jlpoltrack/HP3456A-7.5/hardware/u7-adapter/Render-Copper.png

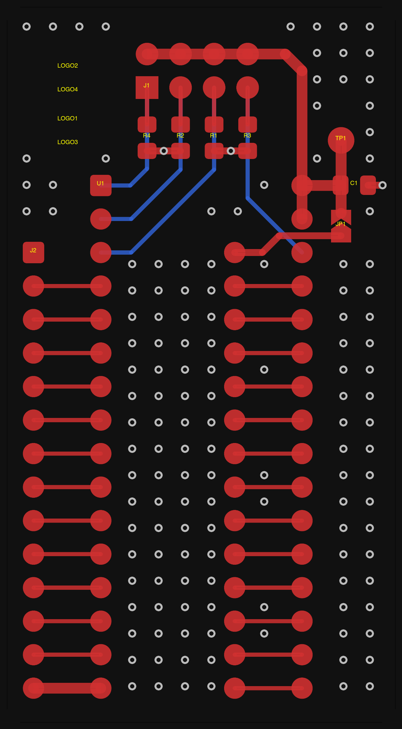
hardware/u7-adapter/Render-Copper.png
