jlpoltrack/HP3456A-7.5/hardware/u7-adapter/renders/Routing-Front.png

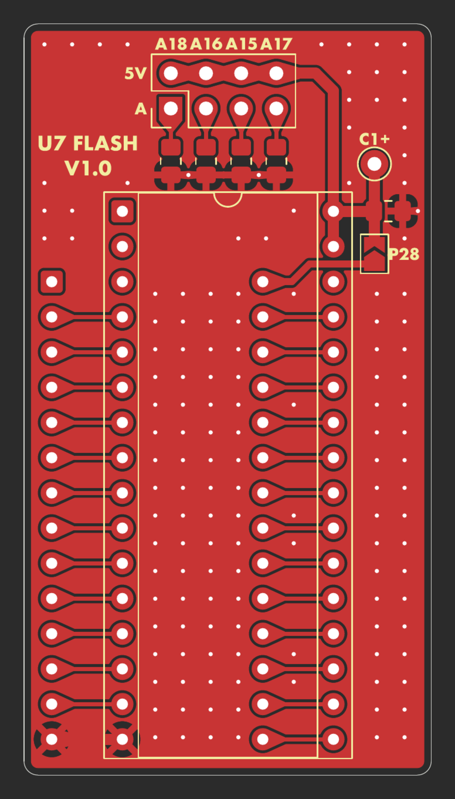
hardware/u7-adapter/renders/Routing-Front.png
