jlpoltrack/HP3456A-7.5/hardware/u7-adapter/production/bom.csv

Designator | Footprint | Quantity | Value | LCSC Part #
C1 | 0805 | 1 | 100n
J1 | PinHeader_2x04_P2.54mm_Vertical | 1 | BANK
J2 | DIP-28_W15.24mm_Plug | 1 | U7
R1, R2, R3, R4 | 0805 | 4 | 10k
U1 | DIP-32_W15.24mm_Socket | 1 | SST39SF040
