jlpoltrack/HP3456A-7.5/hardware/u7-adapter/U7-Flash-Adapter.pdf

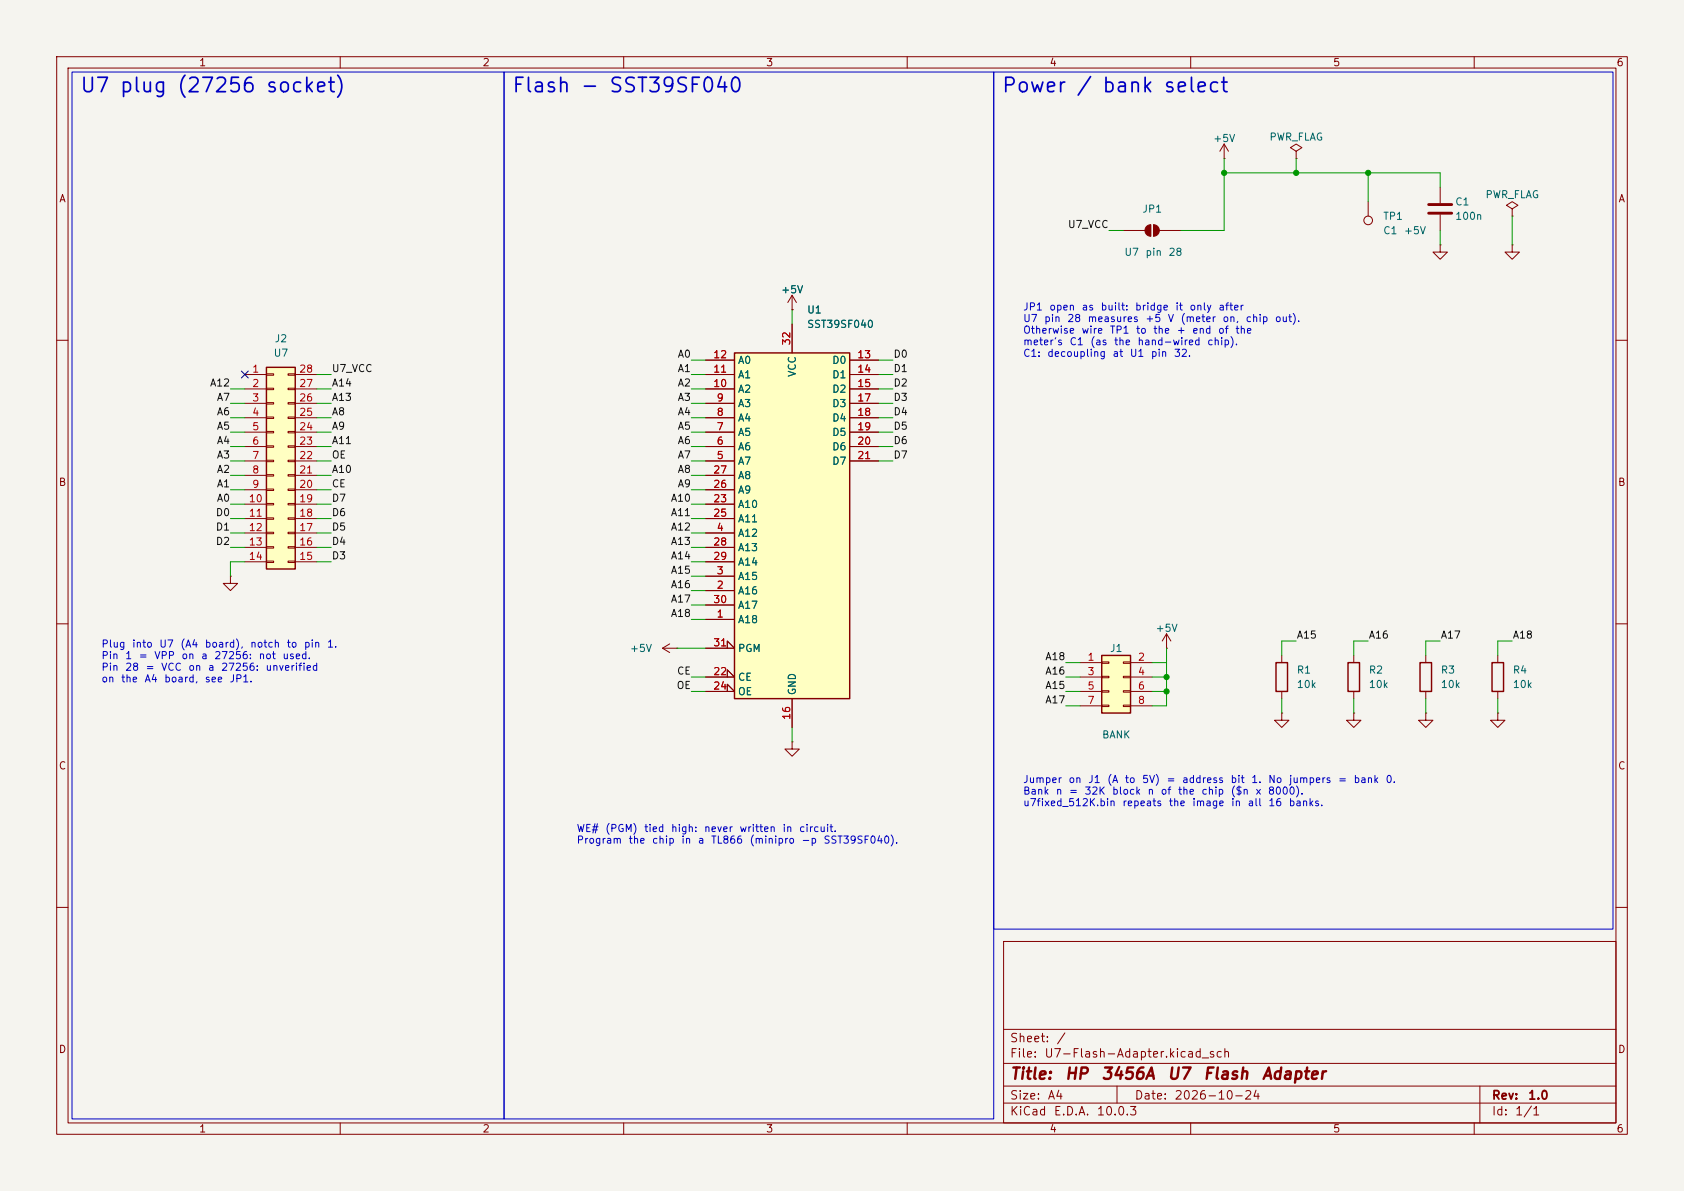
[picture p6: page 1]

A16 WE# (PGM) tied high: never written in circuit. Program the chip in a TL866 (minipro -p SST39SF040).

Plug into U7 (A4 board), notch to pin 1. Pin 1 = VPP on a 27256: not used. Pin 28 = VCC on a 27256: unverified

Sheet: /
File: U7-Flash-Adapter.kicad_sch
Title: HP 3456A U7 Flash Adapter

Size: A4 | Rev: 1.0
KiCad E.D.A. 10.0.3 | Id: 1/1
