jlpoltrack/HP3456A-7.5/hardware/u7-adapter/U7-Flash-Adapter.kicad_pcb

## KiCad design hardware/u7-adapter/U7-Flash-Adapter.kicad_pcb (2026-10-24)

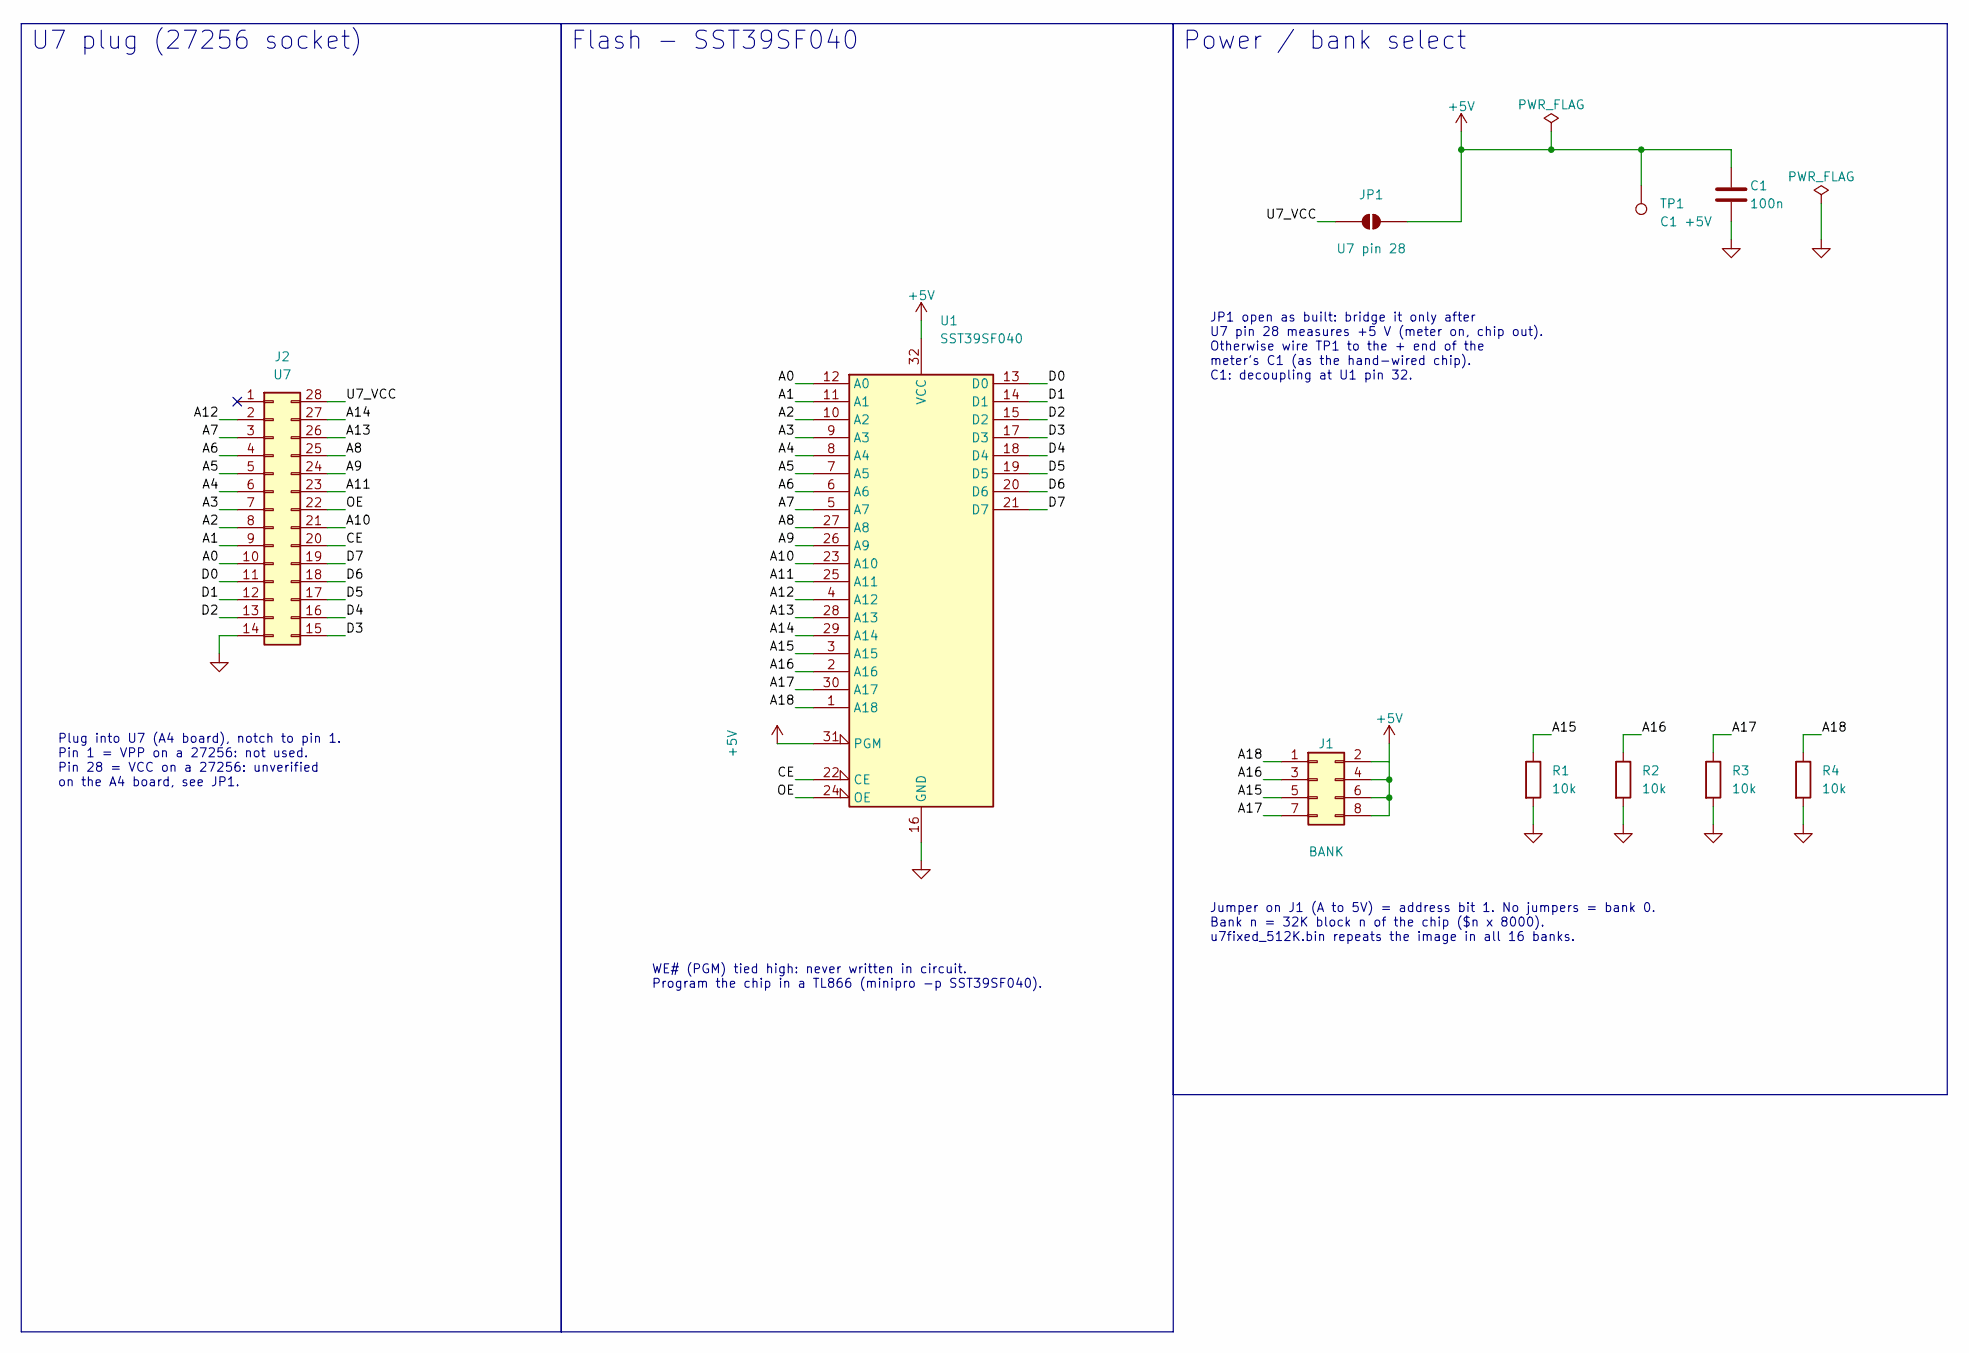
[picture p7: schematic U7-Flash-Adapter.kicad_sch, HP 3456A U7 Flash Adapter]

Parts:
C1: 100n; C_0805_2012Metric_Pad1.18x1.45mm_HandSolder
J1: BANK; PinHeader_2x04_P2.54mm_Vertical
J2: U7; DIP-28_W15.24mm_Plug
JP1: U7 pin 28; SolderJumper-2_P1.3mm_Open_TrianglePad1.0x1.5mm
R1, R2, R3, R4: 10k; R_0805_2012Metric_Pad1.20x1.40mm_HandSolder
TP1: C1 +5V; TestPoint_THTPad_D2.0mm_Drill1.0mm
U1: SST39SF040; DIP-32_W15.24mm_Socket

Connections:
+5V: C1.1, J1.2, J1.4, J1.6, J1.8, JP1.2 (B), TP1.1 (1_1), U1.31 (PGM), U1.32 (VCC)
/A0: J2.10, U1.12 (A0)
/A1: J2.9, U1.11 (A1)
/A2: J2.8, U1.10 (A2)
/A3: J2.7, U1.9 (A3)
/A4: J2.6, U1.8 (A4)
/A5: J2.5, U1.7 (A5)
/A6: J2.4, U1.6 (A6)
/A7: J2.3, U1.5 (A7)
/A8: J2.25, U1.27 (A8)
/A9: J2.24, U1.26 (A9)
/A10: J2.21, U1.23 (A10)
/A11: J2.23, U1.25 (A11)
/A12: J2.2, U1.4 (A12)
/A13: J2.26, U1.28 (A13)
/A14: J2.27, U1.29 (A14)
/A15: J1.5, R1.1, U1.3 (A15)
/A16: J1.3, R2.1, U1.2 (A16)
/A17: J1.7, R3.1, U1.30 (A17)
/A18: J1.1, R4.1, U1.1 (A18)
/CE: J2.20, U1.22 (CE)
/D0: J2.11, U1.13 (D0)
/D1: J2.12, U1.14 (D1)
/D2: J2.13, U1.15 (D2)
/D3: J2.15, U1.17 (D3)
/D4: J2.16, U1.18 (D4)
/D5: J2.17, U1.19 (D5)
/D6: J2.18, U1.20 (D6)
/D7: J2.19, U1.21 (D7)
/OE: J2.22, U1.24 (OE)
/U7_VCC: J2.28, JP1.1 (A)
GND: C1.2, J2.14, R1.2, R2.2, R3.2, R4.2, U1.16 (GND)

Notes on the sheet:
U7 plug (27256 socket)
Flash - SST39SF040
Power / bank select
Plug into U7 (A4 board), notch to pin 1. Pin 1 = VPP on a 27256: not used. Pin 28 = VCC on a 27256: unverified on the A4 board, see JP1.
WE# (PGM) tied high: never written in circuit. Program the chip in a TL866 (minipro -p SST39SF040).
JP1 open as built: bridge it only after U7 pin 28 measures +5 V (meter on, chip out). Otherwise wire TP1 to the + end of the meter's C1 (as the hand-wired chip). C1: decoupling at U1 pin 32.
Jumper on J1 (A to 5V) = address bit 1. No jumpers = bank 0. Bank n = 32K block n of the chip ($n x 8000). u7fixed_512K.bin repeats the image in all 16 banks.

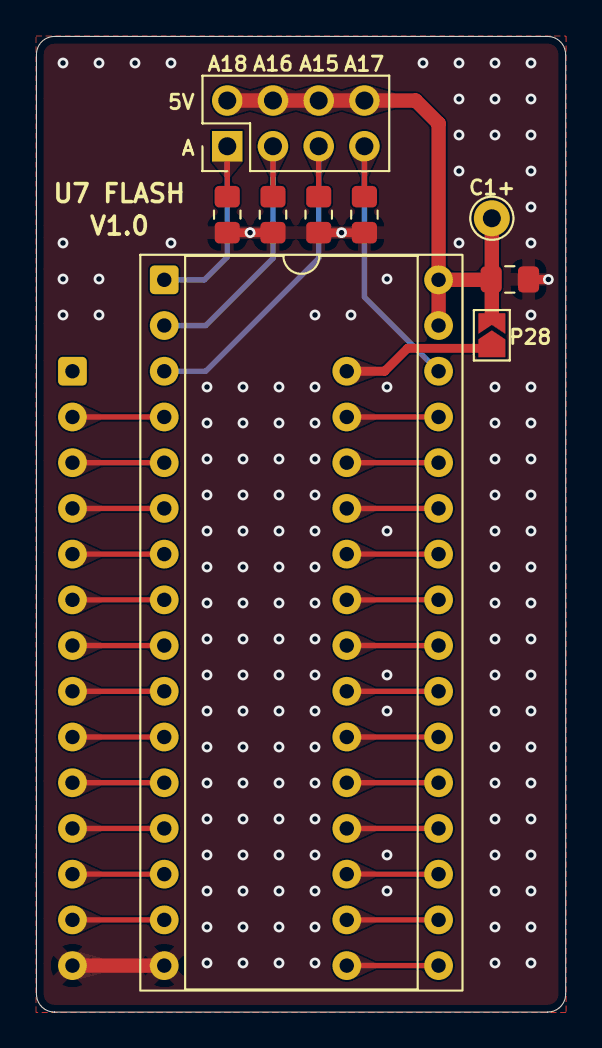
[picture p8: board U7-Flash-Adapter.kicad_pcb from above]

Board: 2 copper layers, 29.4 x 54.2 mm, 14 parts (0 on the bottom side), 32 nets.

Other parts of the board:
LOGO1, LOGO2, LOGO3, LOGO4: title
