jlpoltrack/HP3456A-7.5/src/u7fixed.asm

;
; Commented disassembly of 3456A U7 32K ROM
;
; Disassembled with the DASMx disassembler v 1.40 from http://myweb.tiscali.co.uk/pclare/DASMx/
;
; Some rearrangement of this code has been done to eliminate some jumps and branches
; to improve readability, but otherwise the code is unchanged.
;
; Naming Convention
;
; The disassembler created label names Lhhhh where hhhh is the hex location in the original
; code.  Because of all the deleted branches and jumps (hundreds, actually) in
; straightening up the code, the labels no longer assemble into the previously
; absolute locations, but that doesn't matter.
;
; The disassembler created variable (RAM storage locations) with names Xhhhh, where
; hhhh is again the hex locations.  Where variables have been found to be local to
; only one subroutine, the first letter was changed from "X" to "x" to make it easier
; to distinguish between local and global variables when reading the code.
;
; Where the purpose of a variable or subroutine has been determined with some confidence
; a descriptive name has been given.
;
; Subroutine names are sub*.  I/O addresses are io*.  Names not starting with
; sub or io are variables.
;
;
; ROM Space
;
; The ROM space on the 3456A is the top 32K of the memory map, although the installed
; ROMs only used the top 24K of that.  We're going to use a 32KB (or larger) ROM so
; we will just reserve the first 8K for nothing.

	code
	org	$8000	; 32KB for start of ROM
	rmb	$2000	; 8K of zeros -> code occupies top 24K of ROM space
;


;=====================================================================================

;===============================================================================
;
; Symbols - with notes on their usage
;
;===============================================================================
X0000	equ	$0000
X0001	equ	$0001
X0002	equ	$0002	; used with 0003 for index pointers
X0003	equ	$0003
x0004	equ	$0004	; local in subNMI
x0005	equ	$0005	; local in subNMI
x0008	equ	$0008	; local in subNMI
x0009	equ	$0009	; local in subNMI
x000C	equ	$000C	; local in subNMI
x000E	equ	$000E	; local in subNMI
x0014	equ	$0014	; local in subNMI
X0016	equ	$0016	; local in subNMI
X0024	equ	$0024	; local in subIRQ
X0025	equ	$0025	; local in subIRQ
X0026	equ	$0026	; local in subIRQ
X0027	equ	$0027	; local in subIRQ
X0028	equ	$0028	; local in subIRQ
X0029	equ	$0029	; local in subIRQ
X002A	equ	$002A	; local in subIRQ
X002C	equ	$002C	; local in subIRQ
X002E	equ	$002E	; local in subIRQ
X002F	equ	$002F	; local in subIRQ
X0032	equ	$0032	; local in subIRQ
Digit7	equ	$0040	; ***** MODDED stores the 7th digit *****
flag7Digits	equ	$0041	; ***** MODDED indicates 7 display digits selected  *****
x0044	equ	$0044	; local in many subs
x0045	equ	$0045	; used with above to form index in several subs
x0046	equ	$0046	; local in several subs
x0047	equ	$0047	; used with above to form index in subStoreDisplayToRegister
x0048	equ	$0048	; local in many subs
x0049	equ	$0049	; used with above to form index in many subs
x004A	equ	$004A	; local in many subs
x004B	equ	$004B	; used with above to form index in many subs
x004C	equ	$004C	; local in many subs
x004D	equ	$004D	; used with above to form index in several subs
x004E	equ	$004E	; local in many subs
x004F	equ	$004F	; used with above to form index in several subs
x0050	equ	$0050	; local in many subs
x0051	equ	$0051	; used with above to form index in 2 subs
x0052	equ	$0052	; local in subSetAnnuncByte4
x0054	equ	$0054	; local in several subs
x0056	equ	$0056	; local in subSetAnnuncByte4
x0058	equ	$0058	; local in sub107, sub116
x005A	equ	$005A	; local in subSetAnnuncByte4
x005E	equ	$005E	; local in subSetAnnuncByte4, sub023
x005F	equ	$005F	; used with above to form index in sub023
x0066	equ	$0066	; local in subSetAnnuncByte4
x00BC	equ	$00BC	; local in subWaitForIGStatus, for timeout length of Inguard response
StackStart	equ	$0101	; stack starts at 00FF
X0103	equ	$0103	; flag used in sub081, set in sub116, subIRQ
flagOutputEOI	equ	$0104	; =1 if EOI to be output with readings on HPIB
flagHPIBPackedOutput	equ	$0105	; flag used in sub019, sub023, subHPIBOutputMeasurement, sub078, set in sub
flagHPIBOutputStatus	equ	$0106	; = Talker Active (08) | Ready for Data (10) | Output Empty (40)
flagDispNeedUpdate	equ	$0107	; = 1 if display needs to be updated
X0108	equ	$0108	; counter variable? in sub043, subMathFcnStats
flagMeasFormatted	equ	$0109	; = 1 if current measurement is formatted for output (?)
X010A	equ	$010A	; flag used in subAnnuncNDisplayUpdate, set in sub089
flag010B	equ	$010B
X010C	equ	$010C	; flag used in sub078,sub086,sub103, set in sub060
flagHPIBByteInIntr	equ	$010D	; 1=HPIB will issue interrupts on data received.
x0117	equ	$0117	; local in subCheckIfIGReadyToMeasure,sub060,sub062
x0118	equ	$0118	; used with above as index
x0119	equ	$0119	; local in subGetInguardReading,sub060,sub077,subRST, passes value sub012 to sub011
X011A	equ	$011A	; passes value sub012 to sub011
X011B	equ	$011B	; may be global
x011C	equ	$011C	; local in many subs
InguardStatus	equ	$011D
X011E	equ	$011E	; local in several subs and returns value from sub062
x011F	equ	$011F	; local in sub063, sub088
PressedKeyCode	equ	$0120	; local in subIRQ
flagX0121	equ	$0121
flagHPIBOutput	equ	$0122	; bit4=service requested,bit6,bit7=multiple readings out
InguardCmd	equ	$0123
X0124	equ	$0124	; set in sub016 from table values, used in sub078
IGCmdRegister0	equ	$0125	; global, 69@reset, set from table values in sub098,subTestInguardMeasuring
IGCmdRegister1	equ	$0126
IGCmdRegister2	equ	$0127
IGCmdRegister3	equ	$0128	; set in sub112, used in subHPIBRequestService
IGCmdRegister4	equ	$0129	; bit0,1 are for # digits displayed
X012A	equ	$012A	; measurement digit? set in sub114, used in sub028,sub077,sub116,subNMI
X012B	equ	$012B
X012C	equ	$012C
X012D	equ	$012D
X012E	equ	$012E


; --- 7 byte Registers --- some are described in manual, Table 3.2
; offsets given from address $0125
; data structure:
;	byte0	polarity, FF = negative, 00 = positive
;	byte1	lower nibble holds "overrange" BCD digit (0 or 1), upper nibble is where decimal would be
;	byte2	digits 1,2
;	byte3	digits 3,4
;	byte4	digits 5,6
;	byte5	additional digits for calculation
;	byte6	exponent, 2's compliment if negative

; appears to be used in statistics calculations
X010E	equ	$010E
X010F	equ	$010F
X0110	equ	$0110
X0111	equ	$0111
X0112	equ	$0112
X0113	equ	$0113
X0114	equ	$0114

; R, offset = 0A
RegisterR0	equ	$012F
RegisterR1	equ	$0130
RegisterR2	equ	$0131
RegisterR3	equ	$0132
RegisterR4	equ	$0133
RegisterR5	equ	$0134
RegisterR6	equ	$0135

; Y, offset = 11
RegisterY0	equ	$0136
RegisterY1	equ	$0137
RegisterY2	equ	$0138
RegisterY3	equ	$0139
RegisterY4	equ	$013A
RegisterY5	equ	$013B
RegisterY6	equ	$013C

; Z, offset = 18
RegisterZ0	equ	$013D
RegisterZ1	equ	$013E
RegisterZ2	equ	$013F
RegisterZ3	equ	$0140
RegisterZ4	equ	$0141
RegisterZ5	equ	$0142
RegisterZ6	equ	$0143

; LOWER, offset = 1F
RegisterL0	equ	$0144	; 0144-014A set in subPresetLnUregs to FF 01 99 99 99 00 10 (= -1.999999E9)
RegisterL1	equ	$0145
RegisterL2	equ	$0146
RegisterL3	equ	$0147
RegisterL4	equ	$0148
RegisterL5	equ	$0149
RegisterL6	equ	$014A

; UPPER, offset = 26
RegisterU0	equ	$014B	; 014B-0151 set in subPresetLnUregs to 00 01 99 99 99 00 10 (= +1.999999E9)
RegisterU1	equ	$014C
RegisterU2	equ	$014D
RegisterU3	equ	$014E
RegisterU4	equ	$014F
RegisterU5	equ	$0150
RegisterU6	equ	$0151

; Count, offset = 2D
RegisterC0	equ	$0152
RegisterC1	equ	$0153
RegisterC2	equ	$0154
RegisterC3	equ	$0155
RegisterC4	equ	$0156
RegisterC5	equ	$0157
RegisterC6	equ	$0158

; STAT1, offset = 34, used in statistics calculations, sum of (xi - x1)^2
RegisterSTAT10	equ	$0159
RegisterSTAT11	equ	$015A
RegisterSTAT12	equ	$015B
RegisterSTAT13	equ	$015C
RegisterSTAT14	equ	$015D
RegisterSTAT15	equ	$015E
RegisterSTAT16	equ	$015F

; STAT2, offset = 3B, sum of (xi - x1)
RegisterSTAT20	equ	$0160
RegisterSTAT21	equ	$0161
RegisterSTAT22	equ	$0162
RegisterSTAT23	equ	$0163
RegisterSTAT24	equ	$0164
RegisterSTAT25	equ	$0165
RegisterSTAT26	equ	$0166

; AccumRegister, offset	= 42
AccumRegister0	equ	$0167
AccumRegister1	equ	$0168
AccumRegister2	equ	$0169
AccumRegister3	equ	$016A
AccumRegister4	equ	$016B
AccumRegister5	equ	$016C
AccumRegister6	equ	$016D

; STAT3, offset = 4A, (xi - x1)
RegisterSTAT30	equ	$016F
RegisterSTAT31	equ	$0170
RegisterSTAT32	equ	$0171
RegisterSTAT33	equ	$0172
RegisterSTAT34	equ	$0173
RegisterSTAT35	equ	$0174
RegisterSTAT36	equ	$0175

; also some registers are used but maybe just as temporary scratch variables
X0176	equ	$0176	; register 0176-017C start byte
X017D	equ	$017D	; register 017D-0183 start byte
; register at 0184-018A is used to hold x1 for statistics calculations, but individual bytes are not addre
; --- end of 7 byte registers ---

X018B	equ	$018B
X018C	equ	$018C
CopyOfIGCmdByte	equ	$018D
X018E	equ	$018E
X018F	equ	$018F
BCDRoundupValue	equ	$0190	; either 01 or 05
X0191	equ	$0191	; local in sub085,sub086
X0192	equ	$0192	; local in sub085,sub086
InguardByte3	equ	$0193
InguardByte2	equ	$0194
InguardByte1	equ	$0195
InguardByte0	equ	$0196
AnDUpdatedFlag	equ	$0197	; = 1 once Annunciator and Display updated
X0198	equ	$0198
X0199	equ	$0199	; set in sub027, used in sub012
X019A	equ	$019A	; set in sub027, used in sub012
X019B	equ	$019B
X019C	equ	$019C
X019D	equ	$019D	; flag, 0,1
DecimalPosition	equ	$019E	; set in sub027, used in sub026
x019F	equ	$019F	; local in sub112
X01A0	equ	$01A0	; local in subRunMeasurement
flag01A1	equ	$01A1	; flag, set to 1 or 2 in sub116, cleared in other subs
flagCmdParse	equ	$01A2	; bits0,3,4,6,7 used as flags
CmdChar	equ	$01A3	; ASCII character from command
X01A4	equ	$01A4	; local in sub023
X01A5	equ	$01A5	; local in sub023
X01A6	equ	$01A6	; temp store for MeasExponent
X01A7	equ	$01A7	; temp store for MeasExponentSign
X01A8	equ	$01A8	; local in sub085
X01A9	equ	$01A9	; set in sub028, used in sub085,sub087
MeasArrayORd	equ	$01AA	; MeasArray 1-4 or'd together
X01AB	equ	$01AB	; set in subRunSelfTest,114, used in sub096,sub098,subTestInguardMeasuring
X01AC	equ	$01AC	; local in subRunSelfTest
flagTestMode	equ	$01AD	; bit0 = 1 puts unit in test mode, bit1 action unknown.
flagInguardTimeout	equ	$01AE	; set to FF if timeout waiting for data from Inguard
flagInguard1stTimeout	equ	$01AF	; 0 and set to 1 after 1st timeout from inguard
x01B0	equ	$01B0	; local
X01B1	equ	$01B1
X01B2	equ	$01B2

; 01B8-C5 are formatted measurment, 14 bytes of ASCII
FormattedReading0	equ	$01B8
FormattedReading1	equ	$01B9
FormattedReading2	equ	$01BA
FormattedReading3	equ	$01BB
FormattedReading4	equ	$01BC
FormattedReading5	equ	$01BD
FormattedReading6	equ	$01BE
FormattedReading7	equ	$01BF
FormattedReading8	equ	$01C0
FormattedReading9	equ	$01C1
FormattedReading10	equ	$01C2
FormattedReading11	equ	$01C3
FormattedReading12	equ	$01C4
FormattedReading13	equ	$01C5
X01C6	equ	$01C6
X01C7	equ	$01C7
DecimalDisplayPosition	equ	$01C8	; 6 = leading digit, 5 = next digit, then 4 then 3
X01C9	equ	$01C9
x01CA	equ	$01CA	; local used in several routines

X01CC	equ	$01CC
X01CD	equ	$01CD
X01CE	equ	$01CE
X01CF	equ	$01CF
CmdTableIndex	equ	$01D0	; used to pass value into subCmdTableLookup and as a local in several routines
MeasArray0	equ	$01D1	; least significant digit
MeasArray1	equ	$01D2	; contains reading from Inguard.
MeasArray2	equ	$01D3	; initially packed in 1st 4 bytes as 2 digit BCD
MeasArray3	equ	$01D4	; later 1 BCD digit per byte
MeasArray4	equ	$01D5
MeasArray5	equ	$01D6
MeasArray6	equ	$01D7
MeasArray7	equ	$01D8	; most significant digit
DisplayArray0	equ	$01D9	; these values are sent to the display.  One will be ASCII "."
DisplayArray1	equ	$01DA
DisplayArray2	equ	$01DB
DisplayArray3	equ	$01DC
DisplayArray4	equ	$01DD
DisplayArray5	equ	$01DE
DisplayArray6	equ	$01DF
DisplayArray7	equ	$01E0
flagDisplayHasExponent	equ	$01E1	; = 1 if exponent not zero
DisplayExponentSign	equ	$01E2
DisplayExponent	equ	$01E3
DisplayPolaritySign	equ	$01E4
flagDisplayArrayHasNoDecimal	equ	$01E5	; = 1 when 1 BCD digit/byte
X01E7	equ	$01E7
flag01ED	equ	$01ED	; only set = 1 in sub107,sub112
MeasPolaritySign	equ	$01EE	; contains "+" or "-" ASCII
flagMeasArrayUnpacked	equ	$01EF	; = 1 when 1 BCD digit/byte
tempCmdParseFlag	equ	$01F0
X01F1	equ	$01F1
MeasExponentSign	equ	$01F2	; contains "+" or "-" ASCII
flagMeasHasExponent	equ	$01F3	; = 1 if exponent not zero
MeasExponent	equ	$01F4	; one digit exponent
AnnuncByte0	equ	$01F5	; data that controls front panel LEDs
AnnuncByte1	equ	$01F6
AnnuncByte2	equ	$01F7
AnnuncByte3	equ	$01F8
AnnuncByte4	equ	$01F9
AnnuncByte6	equ	$01FA	; controls leading +/-1 digit (5th byte is exponent polarity, is not stored separate
flagX01FB	equ	$01FB	; only bits6,1,0 used, set and tested in subIRQ, cleared elsewhere
				; bit6 = 1 means entering exponent
flagX01FC	equ	$01FC
HPIBIntrMask	equ	$01FD
X01FE	equ	$01FE	; pointer to something in user RAM
X01FF	equ	$01FF
X0200	equ	$0200	; some indicator of user RAM
X0201	equ	$0201	; pointer to something in user RAM
X0202	equ	$0202	; with above
X0203	equ	$0203	; pointer to next user RAM data storage location
X0204	equ	$0204	; with above
X0205	equ	$0205	; pointer to something in user RAM
X0206	equ	$0206

; 0207 to 05EE appear to be the user storage space (see sub085)
X0789	equ	$0789	; flag
X078A	equ	$078A	; set in sub027, used for comparisons in sub016
flagNumPLCcode	equ	$078B	; # power line cycles to integrate = 0,1,2,3,4 for .01,.1,1,10,100
X078C	equ	$078C	; passes value into sub010, sub012, subInsertDisplayDecimal, set in sub016, sub027
flagOverrange_Maybe	equ	$078D	; flag, values 0,1
ErrorNumber	equ	$078E	; takes values 1-3,5,6, stored in MeasArray1 in subDisplayError
HPIBSerialPollStatus	equ	$078F	; mask used in subHPIBRequestService, takes values 01,02,04,08,10,12,20,80
X0790	equ	$0790	; offset for arrays from 0125, values 0A,11,18,1F,26,2D or 42
X0791	equ	$0791	; word of flag bits
HPIBSerialPollMask	equ	$0792	; mask for HPIB serial poll, values FB,FE
X0793	equ	$0793	; passes register offset into subCopyAccumRegToRegister, values 1E,25,2C,49,57,65
IdxPtr0169	equ	$0794	; used to hold index pointer set to 0RegisterSTAT21
IdxPtr0174	equ	$0796
X0798	equ	$0798	; local in subRunMeasurement
X0799	equ	$0799	; local in sub104
X079A	equ	$079A	; local in sub104
X079B	equ	$079B	; with 079C used with index reg., values F8B1,F857,F861
X079C	equ	$079C
X079D	equ	$079D	; holds offset for register, values given in sub114 0A,11,18,1F,26 or 42
x079E	equ	$079E	; local in subStoreDisplayToRegister for holding version of DisplayExponent
X079F	equ	$079F	; holds index, values F84D,F857,F861,F86B,F875,F87F,F889,F893,F89D,F8A7,F8CB,F8CC,F8F7
IGCmdRegisterNumber	equ	$07A1	; values set in sub114 of 00,01,02,04.  Used in subAdjustIGCmdRegister to cr
IGCmdRegBitClearMask	equ	$07A2	; mask used in subAdjustIGCmdRegister, values set in sub114,116,IRQ

; The following variables are used inside the math subroutines subMath*
X07A5	equ	$07A5	; X07A5-x07C6 are local variables used for math functions
X07A6	equ	$07A6	; in subRegisterAdd-141
X07A7	equ	$07A7	; X07A5-B hold result of register math functions
X07A8	equ	$07A8
X07A9	equ	$07A9
X07AA	equ	$07AA
X07AB	equ	$07AB
X07B0	equ	$07B0
X07B1	equ	$07B1	; X07B1-7 hold 2nd argument passed to register math functions
X07B2	equ	$07B2
X07B3	equ	$07B3
X07B4	equ	$07B4
X07B5	equ	$07B5
X07B6	equ	$07B6
X07B7	equ	$07B7
X07B8	equ	$07B8	; X07B8-E hold 1st argument passed to register math functions
X07B9	equ	$07B9
X07BA	equ	$07BA
X07BB	equ	$07BB
X07BC	equ	$07BC
X07BD	equ	$07BD
X07BE	equ	$07BE
x07BF	equ	$07BF	; set in subMath04,126, not used.
x07C0	equ	$07C0	; local in subMath10-134
x07C1	equ	$07C1	; local in subMath17-141
x07C2	equ	$07C2	; local in subMath10-134
x07C3	equ	$07C3	; local in subMath17-141
x07C4	equ	$07C4	; local in subMath10-134 (index with 07C5)
x07C6	equ	$07C6	; local in subMath10-141 (index with 07C5)
x07C8	equ	$07C8	; local in subMath24-156 (index with 07C9)
x07CA	equ	$07CA	; local in subMath22-157 (index with 07CB)
x07CC	equ	$07CC	; local in subMath22-157 (index with 07CD)
x07CE	equ	$07CE	; local in subMath28

; Memory mapped I/O addresses

ioIsoLogic	equ	$0800
ioVmComplete	equ	$1000
ioRateLite	equ	$1800
ioDAdata	equ	$3000
ioIOreset	equ	$3800
ioHPIB_r0	equ	$4000
ioHPIB_r1	equ	$4001
ioHPIB_r2	equ	$4002
ioHPIB_r3	equ	$4003
ioHPIB_r4	equ	$4004
ioHPIB_r5	equ	$4005
ioHPIB_r6	equ	$4006
ioHPIB_r7	equ	$4007
ioKBrdStrb	equ	$4800
ioKBrdClr	equ	$5000
ioDsplyStrb	equ	$5800
ioAnnunc	equ	$6000
ioSAstrb1	equ	$6800
ioSAstrb2	equ	$7000

;===============================================================================
; Routines for Signature Analysis service procedures
SigAnalyzer1:
	sei
	lds	#$00FF
	stab	ioKBrdClr
	cli
LA008:
	staa	ioSAstrb1
	ldaa	#$55
LA00D:
	ldx	#$0000
LA010:
	staa	$00,x
	cmpa	$00,x
	bne	LA028
	coma
	inx
	staa	$00,x
	cmpa	$00,x
	bne	LA028
	coma
	inx
	cpx	#$0800
	bne	LA010
	coma
	bmi	LA00D
LA028:
	nop
	clra
	sec
	staa	ioSAstrb2
LA02E:
	rora
	staa	ioDAdata
	staa	ioDsplyStrb
	staa	ioAnnunc
	staa	ioVmComplete
	staa	ioRateLite
	staa	ioIOreset
	staa	ioHPIB_r0
	bhi	LA02E
	bra	LA008
;
SigAnalyzer2:
	ldaa	ioKBrdStrb
	anda	#$BF
	staa	ioKBrdClr
	lds	#$00FF
	psha
	cli
	ldab	#$FF
	stab	ioIsoLogic
LA05A:
	staa	ioSAstrb1
	pula
	des
	ldab	#$07
LA061:
	staa	ioDAdata
	asra
	decb
	cmpb	#$00
	bhi	LA061
	ldab	#$8F
	stab	ioIsoLogic
	stab	ioKBrdStrb
	stab	ioKBrdClr
	staa	ioSAstrb2
	bra	LA05A
;
	db	$FF, $FF, $FF, $FF
	db	$FF, $FF, $FF
;
;===============================================================================
; MeasArray7 is the left-most, most signifcant digit
subShiftMeasArrayLeft:
	ldaa	MeasArray6
	staa	MeasArray7
	ldaa	MeasArray5
	staa	MeasArray6
	ldaa	MeasArray4
	staa	MeasArray5
	ldaa	MeasArray3
	staa	MeasArray4
	ldaa	MeasArray2
	staa	MeasArray3
	ldaa	MeasArray1
	staa	MeasArray2
	ldaa	MeasArray0
	staa	MeasArray1
	clr	MeasArray0
	rts
;===============================================================================
; MeasArray7 is the left-most, most signifcant digit
subShiftMeasArrayRight:
	ldaa	MeasArray1
	staa	MeasArray0
	ldaa	MeasArray2
	staa	MeasArray1
	ldaa	MeasArray3
	staa	MeasArray2
	ldaa	MeasArray4
	staa	MeasArray3
	ldaa	MeasArray5
	staa	MeasArray4
	ldaa	MeasArray6
	staa	MeasArray5
	ldaa	MeasArray7
	staa	MeasArray6
	clr	MeasArray7
	rts
;===============================================================================
; packs measurement digits into FormattedReading2-D for HPIB "packed" data output
;
subPackReading:
	ldaa	#$2B		; ASCII "+"
	cmpa	MeasPolaritySign
	bne	LA0EF
	clr	X01CC		; if MeasPolaritySign = "+"
	bra	LA0F4
;
LA0EF:				; sign is not "+"
	ldaa	#$02
	staa	X01CC		; bit2 is polarity, 1 = negative
LA0F4:
	ldaa	MeasArray7	; called "overrange" digit in manual
	cmpa	#$01
	beq	LA130		; branch if 1st digit = 1
	bsr	subShiftMeasArrayRight	; otherwise shift digits down one position
	ldaa	#$2B		; ASCII "+"
	cmpa	MeasExponentSign
	bne	LA110		; branch if negative exponent
	ldab	MeasExponent	; if MeasExponentSign = "+"
	incb
	stab	X01CE		; = exponent+1
	clr	X01CD
	bra	LA147
;
LA110:				; negative exponent
	ldaa	MeasExponent
	tsta
	bne	LA122
	ldab	#$01		; if MeasExponent = 0, 01CE = 01, 01CD = 80
	stab	X01CE
	ldaa	#$80
	staa	X01CD
	bra	LA147
;
LA122:
	ldaa	MeasExponent	; != 0
	deca
	staa	X01CE		; exponent -1
	ldaa	#$80
	staa	X01CD		; if MeasExponent != 0, 01CE = MeasExponent-1, 01CD = 80
	bra	LA147
;
LA130:				; first digit is 1
	ldaa	MeasExponent
	staa	X01CE
	ldaa	#$2B		; ASCII "+"
	cmpa	MeasExponentSign
	bne	LA142
	clr	X01CD		; if MeasExponentSign = "+", 01CE = MeasExponent, 01CD = 00
	bra	LA147
;
LA142:
	ldaa	#$80
	staa	X01CD	; if MeasExponentSign != "+", 01CE = MeasExponent, 01CD = 80

LA147:
	ldaa	X01CE
	asla
	asla
	oraa	X01CC	; = 00 if MeasPolaritySign = "+", else 02
	oraa	X01CD	; = 00 or 80
	oraa	MeasArray7
	staa	FormattedReading2

	; above constructs the 1st packed byte:
	;	bit7: 	exponent sign, 1 = -
	; 	bit6-2: exponent digit
	;	bit1: 	polarity sign, 1 = -
	;	bit0: 	overrange if 1

	ldaa	MeasArray6	; packs 6 digits into three bytes
	asla
	asla
	asla
	asla
	oraa	MeasArray5
	staa	FormattedReading3
	ldaa	MeasArray4
	asla
	asla
	asla
	asla
	oraa	MeasArray3
	staa	FormattedReading4
	ldaa	MeasArray2
	asla
	asla
	asla
	asla
	oraa	MeasArray1
	staa	FormattedReading5
	ldaa	MeasArray7
	tsta
	bne	LA18D
	jsr	subShiftMeasArrayLeft	; if MeasArray7 = 0, shift values in array up one position.
LA18D:
	rts

;===============================================================================
; Formats reading into character FormattedReading including signs, exponent and decimal.
; copies bytes from 01D1-01D8 (MeasArray) converting to ASCII.
; One byte contains ASCII ".", and it is copied too.
;
subFormatReadingForHPIB:
	ldaa	MeasPolaritySign
	staa	FormattedReading0	; 1st byte of formatted reading, the polarity
	ldaa	#$01
	staa	x01B0
LA19B:	;--- begin loop for each digit
	ldaa	x01B0	; loop counter index, 1-8
	cmpa	#$08
	bhi	LA1CC
	ldaa	#$B8
	ldab	#$01
	adda	x01B0
	adcb	#$00
	staa	x0049
	stab	x0048	; 01B9 to 01C1, FormattedReading1-9
	ldaa	#$08
	suba	x01B0	; A = 7...0
	clrb
	adda	#$D1
	adcb	#$01	; base address of MeasArray
	staa	x004D
	stab	x004C	; 01D8 to 01D1 (MeasArray)
	ldx	x004C
	ldaa	$00,x
	oraa	#$30	; turn on bits b4-5, converts BCD to ASCII digits
	ldx	x0048
	staa	$00,x
	inc	x01B0
	bra	LA19B
	;--- end loop
;
	; Array MeasArray has BCD digits and an ASCII ".".  Previous loop
	; copied values adding 30 to each to convert numbers to characters, and
	; added 30 to the decimal point.  This loop goes through all the digits
	; again and puts "." into the formatted array.
LA1CC:	;--- begin loop
	clr	x01CA
LA1CF:
	ldaa	x01CA	; loop counter index, 0-7
	cmpa	#$07
	bhi	LA209
	ldaa	#$D1
	ldab	#$01	; base address of MeasArray
	adda	x01CA
	adcb	#$00
	staa	x0049
	stab	x0048
	ldx	x0048	; 01D1 to 01D8 (MeasArray)
	ldaa	$00,x
	cmpa	#$2E	; ASCII "."
	bne	LA204
	ldab	#$08	; if current byte is decimal point
	subb	x01CA	; B = 8...1
	clra
	addb	#$B8
	adca	#$01
	stab	x004F
	staa	x004E
	ldaa	#$2E	; ASCII "."
	ldx	x004E	; place decimal in 01B9 to 01C1 array
	staa	$00,x
LA204:
	inc	x01CA
	bra	LA1CF
	;--- end loop
;
LA209:
	ldaa	MeasExponentSign
	staa	FormattedReading10
	ldaa	#$30
	oraa	MeasExponent
	staa	FormattedReading11
	rts
;===============================================================================
; sends a write pulse to clock a byte into display controller chip.
; (maybe two are necessary for timing?).
subStrobeDisplay:
	ldaa	#$01
	staa	ioDsplyStrb
	ldaa	#$01
	staa	ioDsplyStrb
	rts
;---------------------------------
; sends a write pulse to clock a byte into display controller chip.
subStrobeAnnunciator:
	ldaa	#$01
	staa	ioAnnunc
	ldaa	#$01
	staa	ioAnnunc
	rts
;===============================================================================
; sends all the data to update the Annunciator LEDs.  Controller chip blanks
; all output until an 8th byte is written.  Any extra writes are ignored.
; Annunciator also controls the exponent sign.
;
subWriteAnnunc:
	ldaa	#$B0		; data is coming command to chip
	staa	ioDAdata
	bsr	subStrobeAnnunciator
	ldaa	AnnuncByte0
	staa	ioDAdata
	bsr	subStrobeAnnunciator
	ldaa	AnnuncByte1
	staa	ioDAdata
	bsr	subStrobeAnnunciator
	ldaa	AnnuncByte2
	staa	ioDAdata
	bsr	subStrobeAnnunciator
	ldaa	AnnuncByte3
	staa	ioDAdata
	bsr	subStrobeAnnunciator
	ldaa	AnnuncByte4
	staa	ioDAdata
	bsr	subStrobeAnnunciator

	; ***** MODDED don't show exponent sign if 7 digit mode *****
	jsr	sub7thDigitShown	; FIX: was ldaa flag7Digits
	bne	LA270		; branch around code that sets exponent sign
	; end mod

	ldaa	flagDisplayHasExponent
	coma
	rora
	bcc	LA271		; branch if there is an exponent sign to display
LA270:				; new label
	ldaa	#$10		; code for display nothing
	staa	ioDAdata
	bra	LA292
;
LA271:				; these will be the exponent signs
	ldaa	#$2B		; ASCII "+"
	cmpa	DisplayExponentSign
	bne	LA27F
	ldab	#$17		; code for display "+"
	stab	ioDAdata
	bra	LA292
;
LA27F:
	ldaa	#$2D		; ASCII "-"
	cmpa	DisplayExponentSign
	bne	LA28D
	ldab	#$14		; code for display "-"
	stab	ioDAdata
	bra	LA292
;
LA28D:
	ldaa	#$10
	staa	ioDAdata
LA292:
	bsr	subStrobeAnnunciator
	ldaa	AnnuncByte6
	staa	ioDAdata
	bsr	subStrobeAnnunciator
	bsr	subStrobeAnnunciator
	rts
;===============================================================================
; fills AnnuncByte0-3, which set the state of all the front panel LEDs except
; for MATH, LISTEN, SRQ, TALK, REMOTE and FILTER (which are done in subSetAnnuncByte4).
;
LA31B:			; rearranged some branches for readability
	rts

subSetAnnuncBytes123:
	ldaa	flagTestMode
	tsta
	bne	LA31B		; if flagTestMode != 0, rts
	ldab	IGCmdRegister0
	lsrb
	lsrb
	lsrb
	lsrb
	lsrb		; IGCmdRegister0 bit5-7 now in bit0-2, max value is 7
	clra
	addb	#$9B	; offset = 0xF79B, possible range F79B to F7A2 -> data
	adca	#$F7		; range in ROM
	stab	x004D
	staa	x004C
	ldaa	IGCmdRegister1
	lsra
	ldab	IGCmdRegister0
	aslb
	aslb
	anda	#$08
	ldx	x004C
	oraa	$00,x	; values are $10, $14, $12, $11, $50, $30, $00, $18
	andb	#$40
	staa	x0054
	orab	x0054
	stab	AnnuncByte0	; data for 7 front panel LEDs
	ldaa	IGCmdRegister1
	lsra
	lsra
	lsra
	lsra
	lsra
	lsra		; IGCmdRegister1 bit6-7 now in bit0-1, max value is 3
	clrb
	adda	#$A2
	adcb	#$F7
	staa	x004B
	stab	x004A	; F7A2 to F7A5
	ldaa	IGCmdRegister4
	lsra
	lsra
	ldab	IGCmdRegister0
	andb	#$01
	ldx	x004A
	orab	$00,x	; values are $18, $00, $30, $50
	anda	#$02
	stab	x0050
	oraa	x0050
	staa	AnnuncByte1	; data for 7 front panel LEDs
	ldaa	#$0F
	anda	IGCmdRegister2
	staa	InguardStatus
	clrb
	adda	#$87
	adcb	#$F7
	staa	x004B
	stab	x004A
	ldaa	flagX0121
	asla
	asla
	anda	#$20
	ldx	x004A
	oraa	$00,x
	staa	AnnuncByte2
	ldaa	#$91
	ldab	#$F7
	adda	InguardStatus
	adcb	#$00
	staa	x0049
	stab	x0048
	ldaa	flagX0121
	anda	#$01
	asla
	asla
	ldx	x0048
	oraa	$00,x
	ldab	#$07
	andb	IGCmdRegister1
	staa	x004E
	clra
	cmpb	#$03
	bne	LA34C
	deca
LA34C:
	anda	#$10
	oraa	x004E
	staa	AnnuncByte3
	rts

;===============================================================================
; Updates the Display digits and Annunciator LEDs. Also determines signs and
; decimal points to display.
; inputs: X010A
;
; Coding for leading digit, AnnuncByte6:
;	- bits 0,1,2 = 010b (02) --> minus sign
;	- bits 0,1,2 = 111b (07) --> plus sign
;	- bits 4,3 = 01b (08) --> digit "1" on
;	- bits 4,3 = 10b (10) --> digit "1" off
;	- bit 5 on (20) --> decimal point displayed

subAnnuncNDisplayUpdate:

	ldaa	#$40
	anda	IGCmdRegister1
	tsta
	bne	LA361		; branch if bit6 = 1
	clr	ioIOreset
LA361:
	ldaa	flagDispNeedUpdate
	rora
	bcc	LA3CD		; if flagDispNeedUpdate = 0, return
	sei			; disable IRQ interrupts
	ldaa	#$10
	staa	ioHPIB_r0	; turn off interrupts from HPIB
	ldaa	X010A		; only set to 01 before first routine call from sub089
	cmpa	#$01
	bne	LA37A		; branch if != 1
	ldab	ioRateLite	; reading this port must strobe the enable line, toggling the LED?
	stab	X01CC		; why store this?  01CC is overwritten below.
LA37A:
	clr	X010A
	ldaa	#$2E		; ASCII "."
	cmpa	DisplayArray6
	bne	LA38B
	ldab	#$01
	stab	x01CA
	bra	LA38E
;
LA3CD:
	rts
LA38B:
	clr	x01CA		; x01CA = 0 if first full digit != ".", else 1
LA38E:
	ldaa	flagDisplayArrayHasNoDecimal
	tsta
	bne	LA39B
	ldab	#$06		; if flagDisplayArrayHasNoDecimal = 0
	stab	X01CC
	bra	LA3A0
LA39B:
	ldaa	#$07
	staa	X01CC
LA3A0:
	ldaa	#$D9
	ldab	#$01		; 01D9 is base of DisplayArray0
	adda	X01CC		; = 6 or 7
	adcb	#$00
	staa	x0049
	stab	x0048
	ldx	x0048
	ldaa	$00,x		; most signifcant digit, DisplayArray6 or DisplayArray7
	cmpa	#$01
	beq	LA412		; branch if a leading "1"
	; a leading "1" not to be displayed
	ldab	#$2B		; ASCII "+"
	cmpb	DisplayPolaritySign
	bne	LA3DD		; branch if not "+"
	ldaa	x01CA		; 0 or 1
	adda	#$02
	clrb
	adda	#$5C		; 5E or 5F
	adcb	#$F9
	staa	x0051
	stab	x0050
	ldx	x0050		; F95E or F95F
	ldaa	$00,x		; 17 or 37 -> "+" or "+."
	staa	AnnuncByte6	; +/-/1 digit on display
	jmp	LA462

LA3DD:
	ldaa	#$2D		; ASCII "-"
	cmpa	DisplayPolaritySign
	bne	LA3FB
	ldab	x01CA		; 0 or 1
	addb	#$0A		; 0A or 0B
	clra
	addb	#$5C		; 66 or 67
	adca	#$F9
	stab	x004D
	staa	x004C
	ldx	x004C
	ldaa	$00,x		; F966 = 12, F967 = 32 -> "-" or "-."
	staa	AnnuncByte6
	bra	LA462
;
LA3FB:				; arrive here if no polarity sign
	ldaa	x01CA		; 0 or 1
	adda	#$06		; 6 or 7
	clrb
	adda	#$5C
	adcb	#$F9
	staa	x004B
	stab	x004A
	ldx	x004A
	ldaa	$00,x		; F962 = 10, F963 = 30 -> " " or "." ?
	staa	AnnuncByte6
	bra	LA462
;
LA412:	; arrive here if a "1" to be displayed.
	ldaa	#$2B		; ASCII "+"
	cmpa	DisplayPolaritySign
	bne	LA42F
	ldab	#$5C
	ldaa	#$F9
	addb	x01CA		; 0 or 1
	adca	#$00
	stab	x004B
	staa	x004A
	ldx	x004A
	ldaa	$00,x		; F95C = 0F, F95D = 2F -> "+1" or "+1." ?
	staa	AnnuncByte6
	bra	LA462
;
LA42F:
	ldaa	#$2D		; ASCII "-"
	cmpa	DisplayPolaritySign
	bne	LA44D
	ldab	x01CA		; 0 or 1
	addb	#$08
	clra
	addb	#$5C
	adca	#$F9
	stab	x004D
	staa	x004C
	ldx	x004C
	ldaa	$00,x		; F964 = 0A, F965 = 2A -> "-1" or "-1." ?
	staa	AnnuncByte6
	bra	LA462
;
LA44D:
	ldaa	x01CA		; 0 or 1
	adda	#$04
	clrb
	adda	#$5C
	adcb	#$F9
	staa	x004B
	stab	x004A
	ldx	x004A
	ldaa	$00,x		; F960 = 08, F961 = 28 -> "1" or "1." ?
	staa	AnnuncByte6

	; now have overrange 1 and polarity sign determined.
LA462:
	jsr	subWriteAnnunc
	ldaa	#$90		; bit7 means mode command to display chip, bit4 means data coming, bit6 means display hex data
	staa	ioDAdata
	jsr	subStrobeDisplay
	ldaa	flagDisplayArrayHasNoDecimal
	cmpa	#$01
	bne	LA497
	clr	x01CA
	bra	LA49C
;
LA497:
	ldaa	#$01
	staa	x01CA		; =0 if flagDisplayArrayHasNoDecimal = 1 else 1
LA49C:
	ldaa	#$2E		; ASCII "."
	cmpa	DisplayArray6
	bne	LA4A8
	ldab	#$01
	stab	x01CA
LA4A8:
	;--- loop begin ---
	ldaa	x01CA
	staa	X01CC
LA4AE:
	ldaa	X01CC		; loop counter, starts at 0 or 1 to 5
	cmpa	#$05
	bhi	LA4E6		; exit loop if 6
	ldaa	X01CC
	inca			; A = 1 or 2 to 6
	ldab	#$06
	staa	x0048
	subb	x0048		; B = 5 to 0
	clra
	addb	#$D9
	adca	#$01		; 01D9 is base of DisplayArray
	stab	x004D
	staa	x004C
	ldx	x004C
	ldaa	$00,x		; 0x01DE to D9, DisplayArray5 to 0
	cmpa	#$2E		; ASCII "."
	bne	LA4DA		; branch if not decimal point

	; display digit with decimal point
	clr	X01CD		; bit5 off turns decimal point on
	bsr	subDisplayDigit	; writes DisplayArray[X01CC] to display with decimal if X01CD = 0
	inc	X01CC		; this position of DisplayArray contained the decimal point, so go to next
	bra	LA4E1

LA4DA:	; display digit without decimal point
	ldaa	#$10
	staa	X01CD		; bit5 on turns decimal point off
	bsr	subDisplayDigit	; writes DisplayArray[X01CC] to display with decimal if X01CD = 0
LA4E1:
	inc	X01CC
	bra	LA4AE
	;--- loop end ---
;
LA4E6:
	ldaa	#$2E		; ASCII "."
	cmpa	DisplayArray0	; least signifcant position
	beq	LA4FA
	ldab	#$06
	stab	X01CC
	ldaa	#$10		; bit5 on turns decimal point off
	staa	X01CD
	jsr	subDisplayDigit	; writes DisplayArray[X01CC] to display with decimal if X01CD = 0

LA4FA:
	;***** MODDED substitute 7th digit for exponent *****
	jsr	sub7thDigitShown	; FIX: was ldaa flag7Digits
	beq	LA4FB		; if flag not set, go to regular exponent code
	ldaa	#$10		; decimal point off
	oraa	Digit7
	staa	ioDAdata	; substitute our digit for exponent
	bra	LA50F
	; end mod

LA4FB:				; new label
	ldaa	flagDisplayHasExponent
	rora
	bcc	LA50A		; branch if no exponent
	; code when there's an exponent
	ldaa	#$10		; decimal point off
	oraa	DisplayExponent
	staa	ioDAdata
	bra	LA50F

	; code when there's no exponent
LA50A:
	ldaa	#$1F		; F means blank digit, 1 means decimal point off
	staa	ioDAdata

LA50F:
	jsr	subStrobeDisplay
	jsr	subStrobeDisplay
	ldaa	AnDUpdatedFlag
	rora
	bcc	LA522
	cli			; clear keyboard interrupt
	ldaa	HPIBIntrMask
	staa	ioHPIB_r0	; restore HPIB interrupts
LA522:
	rts

;===============================================================================
; FIX: Z clear (bne) if the 7th digit should be shown: 7-digit mode, no number
; being entered (flagCmdParse bit0), and 10 or 100 PLC. Destroys A.
sub7thDigitShown:
	ldaa	flag7Digits
	beq	L7THX		; not in 7 digit mode (A = 0, Z set)
	ldaa	#$01
	anda	flagCmdParse
	bne	L7THN		; number entry in progress
	ldaa	flagNumPLCcode
	cmpa	#$02
	bls	L7THN		; below 10 PLC the 7th digit is noise
	ldaa	#$01		; Z clear: show it
	rts
L7THN:
	clra			; Z set: don't show
L7THX:
	rts
;===============================================================================
; Writes one digit to display, with setting decimal point on or off.
; It's wired so the first digit will be displayed on DS2, the left-most
; digit, and last is DS9, the exponent digit.
; Inputs X01CC (digit number), X01CD (decimal point mask)
subDisplayDigit:

	; ***** MODDED if we overwrite the exponent with 7th digit, invert decimals to indicate this *****
	ldaa	flagDisplayHasExponent
	beq	LA525		; skip if there's no exponent
	jsr	sub7thDigitShown	; FIX: was ldaa flag7Digits
	beq	LA525		; skip if not in 7 digit mode
	ldaa	X01CD
	beq	LA524		; branch if 0
	clr	X01CD		; if was 10, set to 0
	bra	LA525
LA524:
	ldaa	#$10
	staa	X01CD		; if it was 0, make it 10
	; end mod

LA525:				; new label
	ldaa	#$06
	suba	X01CC		; 0-6
	clrb
	adda	#$D9
	adcb	#$01		; 01D9 is base of DisplayArray
	staa	x004B
	stab	x004A
	ldx	x004A
	ldaa	$00,x		; 01D9-01DF, DisplayArray0-6
	oraa	X01CD		; turns decimal point on (if 00) or off (if 10)
	staa	ioDAdata
	jsr	subStrobeDisplay
	rts
;===============================================================================
; fills AnnuncByte4 which sets the front panel LEDs for MATH, LISTEN, SRQ,
; TALK, REMOTE and FILTER.

subSetAnnuncByte4:
	ldaa	#$10
	anda	flagHPIBOutput
	tsta
	beq	LA54B	; branch if bit4 = 0
	ldaa	#$40
	anda	ioHPIB_r5	; bit6 is service request state, = 1 if meter has requested service
	tsta
	bne	LA54B	; branch if service requested
	ldaa	#$04
	anda	ioHPIB_r1	; bit2 set if HPIB serial poll function is active
	tsta
	bne	LA54B	; branch if HPIB serial poll function is active
	ldaa	#$EF
	anda	flagHPIBOutput
	staa	flagHPIBOutput	; clear bit4
	clr	ioHPIB_r5	; clear serial poll status and request for service from meter
LA54B:
	ldaa	#$40
	anda	ioHPIB_r1	; bit6 set if meter in HPIB Remote mode
	tsta
	bne	LA55B	; branch if in remote mode
	ldaa	#$10
	oraa	IGCmdRegister4
	staa	IGCmdRegister4	; set bit4
LA55B:
	ldaa	flagTestMode
	tsta
	bne	LA5B9
	ldab	#$40
	andb	ioHPIB_r1	; bit6 set if meter in HPIB Remote mode
	lsrb
	lsrb
	lsrb
	lsrb
	lsrb			; now bit1 = 1 if meter in Remote mode
	ldaa	ioHPIB_r2	; Address Status register
	lsra
	lsra
	lsra
	staa	x004E		; LSB = 1 if meter in Talker Active State
	ldaa	flagHPIBOutput	; bit4 = 1 if HPIB Service Requested
	lsra
	staa	x0050		; bit3 = 1 if HPIB Service Requested
	ldaa	IGCmdRegister1
	asla
	asla
	staa	x0052
	ldaa	ioHPIB_r2
	anda	#$04		; A = 04 if meter in Listener Active state
	stab	x004C		; B = 02 if meter in Remote mode
	oraa	x004C		; A = Listener Active (04) | Remote (02)
	ldab	x004E
	andb	#$01		; B = 01 if meter in Talker Active State
	staa	x0056		; x0056 = Listener Active (04) | Remote (02)
	orab	x0056		; B = Talker Active (01) | Remote (02) | Listener Active (04)
	ldaa	x0050
	anda	#$08		; bit3 = 1 if HPIB Service Requested
	stab	x005A
	oraa	x005A		; A = Talker Active (01) | Remote (02) | Listener Active (04) | Service Requested (08)
	ldab	#$0F
	andb	IGCmdRegister2		; lower nibble
	staa	x005E
	clra			; A = 0
	tstb
	bne	LA5AA
	deca			; if IGCmdRegister2 lower nibble = 0, A = FF, else 00
LA5AA:
	anda	#$10		; A = 10 if IGCmdRegister2 lower nibble = 0
	oraa	x005E		; A = Talker Active (01) | Remote (02) | Listener Active (04) | Service Requested (08) | IGCm
	ldab	x0052
	andb	#$20
	staa	x0066
	orab	x0066
	stab	AnnuncByte4
LA5B9:
	rts
;===============================================================================
;
sub010:
	ldaa	flagX0121
	rora
	bcc	LA5E2	; branch if flagX0121 bit0 = 0
	ldaa	X012D
	oraa	X012C
	oraa	X012E
	tsta
	beq	LA5D8	; branch if X012C,D,E = 0
	ldaa	#$02
	oraa	flagX0121
	staa	flagX0121	; set bit1
	rts
;
LA5D8:
	ldaa	#$FD
	anda	flagX0121
	staa	flagX0121	; clear bit1
	rts
;
LA5E2:
	clr	X012C
	clr	X012D
	clr	X012E
	ldaa	#$08
	anda	IGCmdRegister1
	tsta
	beq	LA62C	; branch if IGCmdRegister1 bit3 = 0
	ldaa	#$02
	oraa	flagX0121
	staa	flagX0121	; set bit1
	ldaa	#$80
	anda	X0198
	clrb
	tsta
	beq	LA605	; branch if X0198 bit7 = 0
	decb
LA605:
	ldaa	flagTestMode
	stab	x004A	; = 00 if X0198 bit7 = 0, else FF
	clrb
	tsta
	beq	LA60F	; branch if flagTestMode = 00
	decb
LA60F:			; B = 0 if flagTestMode = 00, else FF
	orab	x004A
	rorb
	bcc	LA61B	; branch if X0198 bit7 = 0 and flagTestMode = 00
	ldab	#$08
	stab	X012D
	rts
;
LA61B:
	ldaa	#$06
	staa	X012D
	ldaa	#$50
	staa	X012E
	rts		; X012D = 06, X012E = 50 if X0198 bit7 = 0 and flagTestMode = 00
;			; else X012D = 08, X012E = 00

LA62C:			; IGCmdRegister1 bit3 = 0
	ldaa	flagTestMode
	tsta
	beq	LA641	; branch if flagTestMode = 00
	ldab	#$80
	stab	X012E
	ldaa	#$02
	oraa	flagX0121
	staa	flagX0121
	rts		; if flagTestMode != 00, X012E = 80 and flagX0121 bit1 is set
;
LA641:			; flagTestMode = 00
	ldaa	#$80
	anda	X0198
	tsta
	beq	LA65D	; branch if X0198 bit7 = 0
	ldaa	#$60
	staa	X012E
	ldaa	#$02
	oraa	flagX0121
	staa	flagX0121
	rts		; if flagTestMode = 00 and X0198 bit7 = 1, X012E = 60 and flagX0121 bit1 is set
;
LA65D:			; flagTestMode = 00, X0198 bit7 = 0
	ldaa	#$10
	anda	X0198
	clrb
	tsta
	beq	LA667	; branch if X0198 bit4 = 0
	decb
LA667:
	ldaa	X078C
	stab	x004A	; if X0198 bit4 = 0, x004A = 00 else FF
	clrb
	cmpa	#$03
	bcs	LA672	; branch if X078C > 03
	decb
LA672:
	andb	x004A
	rorb
	bcc	LA6AC	; branch if X0198 bit4 = 0 or X078C > 03
	ldab	#$02	; X0198 bit4 = 1 and X078C <= 03
	orab	flagX0121
	stab	flagX0121	; flagX0121 bit1 is set
	ldaa	#$03
	cmpa	X078C
	bne	LA68D
	ldab	#$01
	stab	X012E	; if X078C = 03, X012E = 01
	rts
;
LA68D:			; X078C < 03
	ldaa	#$04
	cmpa	X078C
	bne	LA6A0
	ldab	#$08
	stab	X012E
	rts

LA6A0:
	ldaa	#$80
	staa	X012E
	rts

;
LA6AC:
	ldaa	#$FD
	anda	flagX0121
	staa	flagX0121
	rts

;===============================================================================
;

sub011:
	ldaa	#$80
	anda	x0119
	staa	X011B
	ldaa	#$80
	anda	X011A
	staa	x011C
	ldaa	x011C
	cmpa	X011B
	bne	LA6E3
	ldab	x0119
	cmpb	X011A
	bcc	LA6DE
	ldaa	#$01
	staa	InguardStatus
	bra	LA6E1
;
LA6DE:
	clr	InguardStatus
LA6E1:
	bra	LA6F3
;
LA6E3:
	ldaa	X011B
	tsta
	bne	LA6EE
	clr	InguardStatus
	bra	LA6F3
;
LA6EE:
	ldaa	#$01
	staa	InguardStatus
LA6F3:
	rts

;===============================================================================
; used when meter is in Auto range
sub012:
	ldaa	flagOverrange_Maybe
	tsta
	beq	LA72E
	ldab	X078C
	cmpb	X019A
	bcc	LA724
	ldaa	#$04
	anda	X018B
	tsta
	bne	LA70F
	inc	X018B
LA70F:
	ldaa	#$02
	adda	IGCmdRegister0
	staa	IGCmdRegister0
	clr	flagOverrange_Maybe
	ldaa	#$0C
	oraa	X018B
	staa	X018B	; set bit2-3
	rts			; FIX: was jmp LC9D2; original returns to caller (autorange freeze)
;
LA724:
	ldaa	#$F7
	anda	X018B
	staa	X018B	; clear bit3
	rts			; FIX: was jmp LC9D2; original returns to caller
;
LA72E:
	ldaa	X019B
	cmpa	AccumRegister6
	bne	LA740
	ldab	#$E7
	andb	X018B
	stab	X018B
	bra	LA784
;
LA740:
	ldaa	X019B
	deca
	cmpa	AccumRegister6
	bne	LA77C
	ldaa	AccumRegister1
	clrb
	cmpa	#$01
	bne	LA752
	decb
LA752:
	ldaa	#$F0
	anda	AccumRegister2
	stab	x004C
	clrb
	tsta
	bne	LA75E
	decb
LA75E:
	andb	x004C
	rorb
	bcc	LA772
	ldaa	#$10
	oraa	X018B
	staa	X018B	; set bit4
	bra	LA77A
;
LA772:
	ldaa	#$E7
	anda	X018B
	staa	X018B	; clear bit3
LA77A:
	bra	LA784
LA7F3:
	jmp	LA822
;
LA77C:
	ldaa	#$10
	oraa	X018B
	staa	X018B	; set bit4
LA784:
	ldaa	#$10
	anda	X018B
	tsta
	beq	LA7F3	; branch if bit4 = 0
	ldaa	X078C
	cmpa	X0199
	bls	LA7F3
	ldab	#$03
	andb	X018B
	cmpb	#$03
	bcc	LA7F3
	ldab	IGCmdRegister0
	subb	#$02
	stab	IGCmdRegister0
	ldaa	AccumRegister6
	staa	x0119
	ldaa	X019B
	deca
	staa	X011A
	jsr	sub011
	ldaa	InguardStatus
	clrb
	cmpa	#$01
	bne	LA7C3
	decb
LA7C3:
	ldaa	X078C
	deca
	stab	x0048
	clrb
	cmpa	X0199
	bls	LA7D0
	decb
LA7D0:
	andb	x0048
	rorb
	bcc	LA816
	ldaa	IGCmdRegister0
	suba	#$02
	staa	IGCmdRegister0
	dec	X011A
	jsr	sub011
	ldaa	InguardStatus
	clrb
	cmpa	#$01
	bne	LA7EC
	decb
LA7EC:
	ldaa	X078C
	suba	#$02
	stab	x0048
	clrb
	cmpa	X0199
	bls	LA7FF
	decb
LA7FF:
	andb	x0048
	rorb
	bcc	LA816
	ldaa	IGCmdRegister0
	suba	#$02
	staa	IGCmdRegister0
LA816:
	ldaa	#$FB
	anda	X018B
	oraa	#$08
	staa	X018B	; clear bit2 & set bit3
	rts
;
LA822:
	ldaa	#$E7
	anda	X018B
	staa	X018B	; clear bit3
	rts

;
;===============================================================================
; Causes display digits to be blanked.
subBlankMeasArray:
	ldaa	#$0F		; 0F will cause display digits to be blanked
	staa	MeasPolaritySign
	staa	MeasArray7
	staa	MeasArray6
	staa	MeasArray5
	staa	MeasArray4
	staa	MeasArray3
	staa	MeasArray2
	staa	MeasArray1
	staa	MeasArray0

	staa	Digit7		;***** MODDED clears 7th digit if being displayed

	clr	MeasExponent
	clr	flagMeasHasExponent
	rts
;---------------------------------
; Issue HPIB Service Request if caller parameter matches bit in IGCmdRegister3
subHPIBRequestService:
	ldaa	HPIBSerialPollStatus		; parameter from caller, possible values 01,02,04,08,10,12,20,80
	anda	IGCmdRegister3
	staa	x01CA
	ldaa	x01CA
	tsta
	beq	LA886		; if A = 00, don't request service
	oraa	#$40		; bit6 = 1 for meter to request service
	oraa	ioHPIB_r5	; keep remaining status bits
	staa	ioHPIB_r5	; request service
	ldaa	#$10
	oraa	flagHPIBOutput
	staa	flagHPIBOutput	; set bit4, means HPIB service requested
LA886:
	rts
;---------------------------------
; appears to format digits in MeasArray and set sign
; used when meter is in Auto range
sub015:
	clr	x01CA		; loop index
LA88C:	;--- start loop
	ldaa	x01CA
	cmpa	#$03		; loop over 0,1,2,3
	bhi	LA8AF
	ldaa	#$D1
	ldab	#$01		; base address of MeasArray
	adda	x01CA
	adcb	#$00
	staa	x0049
	stab	x0048
	ldx	x0048
	ldaa	$00,x
	cmpa	#$0F		; if MeasArray0-4 = 0F, make it 00
	bne	LA8AA
	clr	$00,x
LA8AA:
	inc	x01CA
	bra	LA88C
	;--- end loop
;
LA8AF:	; take care of 0F in exponent and sign
	ldaa	#$07
	staa	x01CA
	ldaa	#$0F
	cmpa	MeasExponentSign
	bne	LA8C0
	ldab	#$2B		; ASCII "+" if it was 0F
	stab	MeasExponentSign
LA8C0:
	ldaa	#$0F
	cmpa	MeasExponent
	bne	LA8CA
	clr	MeasExponent	; clear if it was 0F

LA8CA:	;--- loop start, from most significant MeasArray
	; to least signifcant, break if MeasArray != 00 or 0F
	; (i.e., find 1st non-zero digit?
	ldaa	#$D1
	ldab	#$01		; base address of MeasArray
	adda	x01CA		; = 7,6,..0, count down from most to least significant digit
	adcb	#$00
	staa	x0049
	stab	x0048
	ldx	x0048
	ldaa	$00,x		; 1st iteration at MeasArray7
	clrb
	cmpa	#$0F
	bne	LA8E1
	decb
LA8E1:
	stab	x004A		; = FF if MeasArray = 0F, else00
	clrb
	tsta
	bne	LA8E8
	decb
LA8E8:				; B = FF if MeasArray = 00, else 00
	orab	x004A
	ldaa	x01CA		; loop index
	stab	x004E		; = FF if MeasArray = 00 or = 0F, else 00
	clrb
	cmpa	#$FF
	bne	LA8F5		; brach if index not FF, i.e., >= 0
	decb
LA8F5:				; B = FF if index FF, else 00
	comb			; B = 00 if index FF, else FF
	andb	x004E		; = FF if index != FF and (MeasArray = 00 or 0F), else 00
	rorb
	bcc	LA905		; exit loop if index = FF or MeasArray != 00 or 0F
	dec	x01CA
	bra	LA8CA
	;--- loop end
;
LA905:
	ldaa	#$D1
	ldab	#$01	; base address of MeasArray
	adda	x01CA	; 1st non 00 or 0F digit
	adcb	#$00
	staa	x0049
	stab	x0048
	ldx	x0048
	ldaa	$00,x
	cmpa	#$2E	; ASCII "."
	bne	LA96C	; branch if digit is not decimal point
	dec	x01CA	; go to next lower significant digit

LA91D:	;--- loop, appears to adjust exponent
	ldaa	#$D1
	ldab	#$01	; base address of MeasArray
	adda	x01CA
	adcb	#$00
	staa	x0049
	stab	x0048
	ldx	x0048
	ldaa	$00,x	; 1st digit to right of decimal point
	clrb
	tsta
	bne	LA933	; branch if not a 0
	decb
LA933:			; B = 00 if leading digit != 0, else FF
	ldaa	x01CA
	stab	x004A
	clrb
	cmpa	#$FF
	bne	LA93E
	decb
LA93E:			; B = 00 if index >= 0, else FF
	comb		; B = FF if index >= 0, else 00
	andb	x004A
	rorb
	bcc	LA9D3	; branch if leading digit != 0 or index < 0
	dec	x01CA
	ldaa	MeasExponent
	tsta
	bne	LA952	; branch if exponent != 0
	ldab	#$2D	; ASCII "-"
	stab	MeasExponentSign
LA952:
	ldaa	#$2B	; ASCII "+"
	cmpa	MeasExponentSign
	bne	LA95E
	dec	MeasExponent
	bra	LA968
;
LA95E:
	ldaa	#$2D	; ASCII "-"
	cmpa	MeasExponentSign
	bne	LA968
	inc	MeasExponent
LA968:
	bra	LA91D
	;--- end loop

LA9D3:
	jmp	LAA3F
;
	;--- loop, apears to also adjust exponent
LA96C:			; arrive here if leading digit is not decimal point
	ldaa	#$D1
	ldab	#$01	; base address of MeasArray
	adda	x01CA
	adcb	#$00
	staa	x0049
	stab	x0048
	ldx	x0048
	ldaa	$00,x
	clrb
	cmpa	#$09
	bhi	LA983
	decb
LA983:
	andb	#$FF
	ldaa	x01CA
	stab	x004C
	clrb
	cmpa	#$FF
	bne	LA990
	decb
LA990:
	comb
	andb	x004C
	rorb
	bcc	LA9C7
	dec	x01CA
	ldaa	MeasExponent
	tsta
	bne	LA9A4
	ldab	#$2B	; ASCII "+"
	stab	MeasExponentSign
LA9A4:
	ldaa	#$2B	; ASCII "+"
	cmpa	MeasExponentSign
	bne	LA9B0
	inc	MeasExponent
	bra	LA9C5
;
LA9B0:
	ldaa	#$2D	; ASCII "-"
	cmpa	MeasExponentSign
	bne	LA9C5
	dec	MeasExponent
	ldaa	MeasExponent
	tsta
	bne	LA9C5
	ldab	#$2B	; ASCII "+"
	stab	MeasExponentSign
LA9C5:
	bra	LA96C
	;--- end loop
;
LA9C7:
	clr	X01CC
LA9CA:
	ldaa	X01CC
	cmpa	#$03
	bhi	LA9F2		; loop over 0,1,2,3
	ldaa	#$D1
	ldab	#$01	; base address of MeasArray
	adda	X01CC
	adcb	#$00
	staa	x0049
	stab	x0048
	ldx	x0048
	ldaa	$00,x
	cmpa	#$0F
	bne	LA9ED
	clr	$00,x		; change values 0F to 00
LA9ED:
	inc	X01CC
	bra	LA9CA
;
LA9F2:
	ldaa	#$D1
	ldab	#$01	; base address of MeasArray
	adda	x01CA
	adcb	#$00
	staa	x0049
	stab	x0048
	ldx	x0048
	ldaa	$00,x
	cmpa	#$2E	; ASCII "."
	bne	LAA3F	; branch if not "."

LAA07:	;--- loop moves digits up one place
	ldaa	x01CA
	deca
	clrb
	cmpa	#$FF
	bne	LAA11
	decb
LAA11:			; B = FF if x01CA != 0
	comb
	rorb
	bcc	LAA3C	; branch if B = 0, x01CA = 0
	ldab	#$D1
	staa	x0048
	ldaa	#$01
	addb	x01CA
	adca	#$00
	stab	x004F
	staa	x004E
	ldaa	x0048	; x0048 = x01CA - 1
	clrb
	adda	#$D1
	adcb	#$01	; base address of MeasArray
	staa	x0051
	stab	x0050
	ldx	x0050
	ldaa	$00,x	; @ 01D1 + x01CA - 1
	ldx	x004E
	staa	$00,x	; @ 01D1 + x01CA
	dec	x01CA
	bra	LAA07
	;--- end loop
LAA3C:
	clr	MeasArray0

LAA3F:
	ldaa	#$07
	staa	x01CA
LAA44:	;--- loop left justifies data in MeasArray
	ldaa	#$0F
	clrb
	cmpa	MeasArray7
	bne	LAA4D
	decb		; FF if MeasArray7 is blanked (0F)
LAA4D:
	ldaa	#$2E	; ASCII "."
	stab	x0048
	clrb
	cmpa	MeasArray7
	bne	LAA58
	decb
LAA58:			; B = 00 if MeasArray7 != 2E, else FF
	orab	x0048
	ldaa	MeasArray7
	stab	x004C	; = 00 if MeasArray7 != 0F or 2E
	clrb
	tsta
	bne	LAA64
	decb
LAA64:			; B = 00 if MeasArray7 != 00, else FF
	orab	x004C
	ldaa	x01CA
	stab	x0050	; = 00 if MeasArray7 != 0F or 2E or 00
	clrb
	cmpa	#$FF
	bne	LAA71	; branch if index >= 0
	decb
LAA71:			; B = 00 if index >= 0, else FF
	comb		; B = 00 if index < 0, else FF
	andb	x0050
	rorb
	bcc	LAA7F	; branch to rts if MeasArray7 != 0F or 2E or 00 or index <= 0
	jsr	subShiftMeasArrayLeft
	dec	x01CA
	bra	LAA44
	;--- loop end

LAA7F:
	rts

;===============================================================================
; returns InguardStatus bit3-0 or 5 in DecimalDisplayPosition
; uses X078A,C, flagTestMode
sub016:
	ldaa	flagTestMode	; possible values 0,1,3
	tsta
	beq	LAA97		; branch if flagTestMode = 0
	ldab	#$05
	stab	DecimalDisplayPosition
	ldaa	#$02
	staa	X078C		; if flagTestMode != 0, DecimalDisplayPosition = 5 and X078C = 02, else is set elsewhere
	clr	InguardStatus
	bra	LAAE4
;
LAA97:
	ldaa	#$0A
	clrb
	cmpa	X078A
	bne	LAAA0
	decb
LAAA0:				; B = FF if X078A = 0A
	ldaa	#$0C
	stab	x0048
	clrb
	cmpa	X078A
	bne	LAAAB
	decb
LAAAB:				; B = FF if X078A = 0C
	orab	x0048
	rorb
	bcc	LAACB		; branch if X078A != 0A or 0C
	ldab	#$AB		; X078A = 0A or 0C
	ldaa	#$F7
	addb	X078C		; may be 0-7
	adca	#$00
	stab	x004F
	staa	x004E
	ldx	x004E
	ldaa	$00,x
	; X078C =	0	1	2	3	4	5
	; A =		04	03 	35 	34	33 	65
	staa	InguardStatus
	anda	#$0F
	staa	DecimalDisplayPosition
	bra	LAAE4
;
LAACB:				; X078A != 0A or 0C
	ldaa	#$A6
	ldab	#$F7		; F7AB - F7A6 = 5, so X078C range 0-4?
	adda	X078C
	adcb	#$00
	staa	x0049
	stab	x0048
	ldx	x0048
	ldaa	$00,x
	; X078C =	0	1	2	3	4	5
	; A =		D4	06 	05 	04 	03	04
	staa	InguardStatus
	anda	#$0F
	staa	DecimalDisplayPosition


LAAE4:
	ldaa	#$F0
	anda	InguardStatus
	staa	InguardStatus	; clear bit3-0
	bpl	LAAF7		; branch if MSB = 0
	ldaa	#$FF
	bra	LAAF8
;
LAAF7:
	clra
LAAF8:				; A = 00 if InguardStatus bit7 = 0, else FF
	rora
	bcc	LAB07		; branch if InguardStatus bit7 = 0
	ldaa	#$2D		; ASCII "-"
	staa	MeasExponentSign
	ldaa	#$03
	staa	MeasExponent	; -3 must be only allowed negative exponent
	bra	LAB16
;
LAB07:
	ldaa	#$2B		; ASCII "+"
	staa	MeasExponentSign
	ldaa	InguardStatus
	lsra
	lsra
	lsra
	lsra
	staa	MeasExponent	; InguardStatus bits 6-4 become exponent when positive

LAB16:
	ldaa	#$0A
	clrb
	cmpa	X078A
	bne	LAB1F
	decb
LAB1F:				; B = FF if X078A = 0A
	ldaa	#$0C
	stab	x0048
	clrb
	cmpa	X078A
	bne	LAB2A
	decb
LAB2A:				; B = FF if X078A = 0C
	orab	x0048
	rorb
	bcc	LAB45		; branch if X078A != 0A or 0C
	ldab	#$51		; X078A = 0A or 0C
	ldaa	#$F9
	addb	X078C
	adca	#$00
	stab	x004F
	staa	x004E
	ldx	x004E
	ldaa	$00,x
	; X078C =	0	1	2	3	4	5
	; A =		0C 	10	14 	18 	1C 	20
	staa	X0124
	bra	LAB59
;
LAB45:				; X078A != 0A or 0C
	ldaa	#$57
	ldab	#$F9		; F957 - F951 = 6, so X078C has range 0-5?
	adda	X078C
	adcb	#$00
	staa	x0049
	stab	x0048
	ldx	x0048
	ldaa	$00,x
	; X078C =	0	1	2	3	4	5
	; A =		00 	04 	08 	0C	10 	0F
	staa	X0124
LAB59:
	ldaa	MeasExponent
	staa	X01A6
	ldaa	MeasExponentSign
	staa	X01A7
	ldaa	MeasExponent
	tsta
	bne	LAB70
	clr	flagMeasHasExponent
	rts
;
LAB70:
	ldaa	#$01
	staa	flagMeasHasExponent
	rts

;===============================================================================
; puts measurement into register format
; used when meter is in Auto range
subCopyMeasToAccumReg:
	ldaa	#$2D	; ASCII "-"
	cmpa	MeasPolaritySign
	bne	LAB86
	ldab	#$FF
	stab	AccumRegister0	; FF indicates negative
	bra	LAB89
;
LAB86:
	clr	AccumRegister0	; = 00 if +, else FF
LAB89:
	ldaa	MeasArray7	; most significant digit
	staa	AccumRegister1
	ldaa	MeasArray6
	asla
	asla
	asla
	asla
	oraa	MeasArray5
	staa	AccumRegister2	; digits 2,3
	ldaa	MeasArray4
	asla
	asla
	asla
	asla
	oraa	MeasArray3
	staa	AccumRegister3	; digits 4,5
	ldaa	MeasArray2
	asla
	asla
	asla
	asla
	oraa	MeasArray1
	staa	AccumRegister4	; digits 6,7
	clr	AccumRegister5
	ldaa	#$2D	; ASCII "-"
	cmpa	MeasExponentSign
	bne	LABCC
	ldab	MeasExponent
	comb
	stab	AccumRegister6
	inc	AccumRegister6	; compliment + 1
	bra	LABD2
;
LABCC:
	ldaa	MeasExponent
	staa	AccumRegister6
LABD2:
	rts
;---------------------------------
; Stores packed reading from FormattedReading2-5 to RAM at position pointed to by X0203-4
; inputs: IGCmdRegister4, X0200, X0205, X0206
subStoreReading:
	ldaa	#$08
	anda	IGCmdRegister4	; bit3 = 1 means OK to store data
	tsta
	beq	LAC4C	; branch if bit3 = 0
	ldaa	#$30
	anda	X0200
	tsta
	bne	LAC4C	; branch if bit4,5 != 00b, so X0200 > 10
	ldaa	X0200
	anda	#$01
	tsta
	beq	LAC0D	; branch if bit0 = 0
	ldaa	#$0E
	anda	X0200
	staa	X0200	; keep bits 3-1
	ldaa	#$02
	oraa	X0200
	staa	X0200	; set bit1
	ldaa	X0206
	ldab	X0205
	adda	#$01
	adcb	#$00
	staa	X0204
	stab	X0203	; X0203-4 = X0205-6 + 1
LAC0D:
	ldaa	#$78
	ldab	#$05	; limit on user RAM location
	suba	X0204
	sbcb	X0203	; 0578 - X0203-4
	bcc	LAC25	; branch if subrraction result is non-negative
	clr	X0200	; = 0	Amount of remaining User RAM?
	ldaa	#$F7
	anda	IGCmdRegister4
	staa	IGCmdRegister4	; clear bit3
LAC4C:
	rts
;
LAC25:
	ldaa	#$02
	anda	X0200
	tsta
	beq	LAC4C	; branch if bit1 = 0
	ldaa	#$03
	clrb
	adda	X0204
	adcb	X0203
	adda	#$07
	adcb	#$02
	staa	x004F
	stab	x004E	; = 0207 + X0203-4 + 3
	ldaa	FormattedReading5
	ldx	x004E
	staa	$00,x	; copy FormattedReading5 to this location
	ldaa	#$02
	clrb
	adda	X0204
	adcb	X0203
	adda	#$07
	adcb	#$02
	staa	x004B
	stab	x004A	; = 0207 + X0203-4 + 2
	ldaa	FormattedReading4
	ldx	x004A
	staa	$00,x	; copy FormattedReading4 to this location
	ldaa	X0204
	ldab	X0203
	adda	#$01
	adcb	#$00
	adda	#$07
	adcb	#$02
	staa	x004B
	stab	x004A	; = 0207 + X0203-4 + 1
	ldaa	FormattedReading3
	ldx	x004A
	staa	$00,x	; copy FormattedReading3 to this location
	ldaa	#$07
	ldab	#$02
	adda	X0204
	adcb	X0203
	staa	x0049
	stab	x0048	; = 0207 + X0203-4
	ldaa	FormattedReading2
	ldx	x0048
	staa	$00,x	; copy FormattedReading2 to this location
	ldaa	#$04
	clrb
	adda	X0204
	adcb	X0203
	staa	X0204
	stab	X0203	; increments X0203-4 by 4
	rts
;---------------------------------

sub019:
	sei
	ldaa	#$10
	staa	ioHPIB_r0	; turn off interrupts from HPIB
	ldaa	#$0A		; bit3,1
	anda	X018C
	staa	InguardStatus
	ldaa	#$03
	anda	X0200
	clrb
	tsta
	beq	LACC9
	decb
LACC9:
	orab	flagHPIBPackedOutput
	tstb
	beq	LACEF
	ldaa	InguardStatus
	tsta
	beq	LACDC
	ldab	#$43	; ASCII "C"
	stab	FormattedReading2
	bra	LACE1
;
LACDC:
	ldaa	#$41	; ASCII "A"
	staa	FormattedReading2
LACE1:
	ldaa	#$99
	staa	FormattedReading3
	staa	FormattedReading4
	staa	FormattedReading5
	jsr	subStoreReading
LACEF:
	ldaa	flagHPIBPackedOutput
	tsta
	bne	LAD37
	ldab	#$2E	; ASCII "."
	stab	FormattedReading8
	ldaa	#$45	; ASCII "E"
	staa	FormattedReading9
	ldaa	#$39	; ASCII "9"
	staa	FormattedReading2
	staa	FormattedReading3
	staa	FormattedReading4
	staa	FormattedReading5
	staa	FormattedReading6
	staa	FormattedReading7
	staa	FormattedReading11
	ldaa	#$31	; ASCII "1"
	staa	FormattedReading1
	ldaa	#$2B	; ASCII "+"
	staa	FormattedReading10
	ldaa	InguardStatus
	tsta
	beq	LAD32
	ldab	#$2D	; ASCII "-"
	stab	FormattedReading0
	bra	LAD37
;
LAD32:
	ldaa	#$2B	; ASCII "+"
	staa	FormattedReading0
LAD37:
	cli
	ldaa	#$A5
	staa	ioHPIB_r0	; turn on interrupts from HPIB
	rts
;---------------------------------

subCopyDisp2MeasArray:
	ldaa	flagDisplayHasExponent
	staa	flagMeasHasExponent
	ldaa	DisplayExponentSign
	staa	MeasExponentSign
	ldaa	DisplayExponent
	staa	MeasExponent
	ldaa	DisplayPolaritySign
	staa	MeasPolaritySign
	ldaa	flagDisplayArrayHasNoDecimal
	staa	flagMeasArrayUnpacked
	ldaa	DisplayArray0
	staa	MeasArray0
	ldaa	DisplayArray1
	staa	MeasArray1
	ldaa	DisplayArray2
	staa	MeasArray2
	ldaa	DisplayArray3
	staa	MeasArray3
	ldaa	DisplayArray4
	staa	MeasArray4
	ldaa	DisplayArray5
	staa	MeasArray5
	ldaa	DisplayArray6
	staa	MeasArray6
	ldaa	DisplayArray7
	staa	MeasArray7
	rts
;---------------------------------

subCopyMeas2DispBytes:
	ldaa	flagMeasHasExponent
	staa	flagDisplayHasExponent
	ldaa	MeasExponentSign
	staa	DisplayExponentSign
	ldaa	MeasExponent
	staa	DisplayExponent
	ldaa	MeasPolaritySign
	staa	DisplayPolaritySign
	ldaa	flagMeasArrayUnpacked
	staa	flagDisplayArrayHasNoDecimal
	ldaa	MeasArray0
	staa	DisplayArray0
	ldaa	MeasArray1
	staa	DisplayArray1
	ldaa	MeasArray2
	staa	DisplayArray2
	ldaa	MeasArray3
	staa	DisplayArray3
	ldaa	MeasArray4
	staa	DisplayArray4
	ldaa	MeasArray5
	staa	DisplayArray5
	ldaa	MeasArray6
	staa	DisplayArray6
	ldaa	MeasArray7
	staa	DisplayArray7
	rts
;===============================================================================
; Update Annunciator & Display if they are ready for new data
subUpdateDisplayIfReady:
	ldaa	#$40
	anda	ioKBrdStrb	;bit6 high indicates the display is ready to write to.
	tsta
	beq	LADED
	jsr	subAnnuncNDisplayUpdate
LADED:
	rts
;===============================================================================
; calling routine sets X0790 (register offset) and X0791 (possible values 0D,20,2A,2C)
; used when meter is in Auto range
sub023:
	ldaa	#$02
	staa	x01B0	; loop index 2,4,6,8
LADF5:
	;--- loop moves data array to 01D1-8 (MeasArray), unpacking and reversing byte order
	ldaa	x01B0
	cmpa	#$08
	bhi	LAE63
	ldaa	x01B0
	clrb		; B = 00
	lsrb		; shift right, C = 0
	rora		; idx/2
	staa	x011C	; 1 to 4
	adda	#$01
	adcb	#$00
	staa	X011E	; 2 to 5
	ldaa	#$09
	suba	x01B0	; A = 7,5,3,1
	clrb
	adda	#$D1
	adcb	#$01	; 01D8,6,4,2  (MeasArray)
	staa	x004B
	stab	x004A
	ldaa	x011C	; 1 to 4
	adda	X0790	; 0A,11,18,1F,26,2D or 42 from calling routine, offsets to data arrays
	clrb
	adda	#$25
	adcb	#$01
	staa	x004F
	stab	x004E
	ldx	x004E	; 0130-0133, 0137-013A, etc (on a voltage measurement, was 0168)
	ldaa	$00,x
	anda	#$0F	; lower nibble
	ldx	x004A	; 01D8,6,4,2  (MeasArray)
	staa	$00,x	; 01D8...
	ldaa	#$08
	suba	x01B0	; 6,4,2,0
	clrb
	adda	#$D1
	adcb	#$01	; base address of MeasArray
	staa	x004B
	stab	x004A	; 01D7,5,3,1
	ldaa	X011E	; 2 to 5
	adda	X0790
	clrb
	adda	#$25
	adcb	#$01
	staa	x004F
	stab	x004E
	ldx	x004E	; 0131-0134, etc (on a voltage measurement, was 0169)
	ldaa	$00,x
	lsra
	lsra
	lsra
	lsra		; upper nibble
	ldx	x004A	; 01D7,5,3,1
	staa	$00,x
	ldaa	x01B0
	adda	#$02
	staa	x01B0
	bra	LADF5
	;--- end loop
;
LAE63:
	ldaa	#$20
	anda	X0791	; 2nd parameter from caller routine, intitially 0D,20,2A or 2C
	tsta
	beq	LAE86	; branch if bit5 = 1
	ldaa	MeasArray7
	tsta
	bne	LAE86	; branch if MeasArray7 != 0 (negative polarity?)
	ldab	#$0B
	orab	X0791
	stab	X0791	; set bits 0,1,3 if bit5 = 0 and MeasArray7 = 0

LAE86:
	ldaa	#$7F
	anda	X0791
	staa	X0791	; clear bit7
	ldaa	#$06
	adda	X0790	; 0790 has an offset to arrays at 012F,0136,013D,0144,014B,0167
	clrb
	adda	#$25
	adcb	#$01
	staa	x004B
	stab	x004A
	ldx	x004A	; 0135, 013C, i.e., highest byte of array
	ldaa	$00,x
	anda	#$80
	tsta
	beq	LAEC5	; branch if bit7 = 0, i.e., positive exponent
	ldaa	#$2D	; ASCII "-" if bit7 = 1 (indicates negative reading)
	staa	MeasExponentSign
	ldaa	#$06
	adda	X0790
	clrb
	adda	#$25
	adcb	#$01
	staa	x004B
	stab	x004A
	ldx	x004A	; 0135, 013C, etc
	ldaa	$00,x
	coma		; 1's compliment
	staa	MeasExponent
	inc	MeasExponent	; 2's compliment as negative exponent is given in complimented form
	bra	LAEDF
;
LAEC5:			; exponent is positive
	ldaa	#$2B	; ASCII "+"
	staa	MeasExponentSign
	ldaa	#$06
	adda	X0790
	clrb
	adda	#$25
	adcb	#$01
	staa	x004B
	stab	x004A
	ldx	x004A	; 0135, 013C, etc
	ldaa	$00,x
	staa	MeasExponent

LAEDF:
	ldaa	#$2B	; ASCII "+"
	cmpa	MeasExponentSign
	bne	LAF52	; branch if "-"
	ldab	MeasArray7
	clra
	cmpb	#$01
	bne	LAEEF
	deca
LAEEF:			; A = 00 if MeasArray7 != 01 else FF
	staa	x004A
	ldaa	MeasExponent
	clrb
	cmpa	#$10
	bls	LAEFA
	decb
LAEFA:			; B = 00 if MeasExponent <= 10 else FF
	andb	x004A
	ldaa	MeasArray7
	stab	x004E	; = FF if MeasArray7 = 01 and MeasExponent > 10
	clrb
	cmpa	#$01
	beq	LAF07	; branch if MeasArray7 = 01
	decb
LAF07:			; B = 00 if MeasArray7 = 01 else FF
	ldaa	MeasExponent
	stab	x0050	; = 00 if MeasArray7 = 01 else FF
	clrb
	cmpa	#$0F
	bls	LAF12
	decb
LAF12:			; B = 00 if MeasExponent <= 0F else FF
	andb	x0050	; = FF if MeasArray7 != 01 and MeasExponent > 0F
	orab	x004E	; = FF if (MeasArray7 != 01 and MeasExponent > 0F) or (MeasArray7 = 01 and MeasExponent > 10)
	tstb
	beq	LAF52	; branch if above is 00
	ldab	#$2E	; ASCII "."
	andb	X018C
	tstb
	bne	LAF47
	ldab	#$25
	ldaa	#$01
	addb	X0790
	adca	#$00
	stab	x005F
	staa	x005E
	ldx	x005E		; possible locations 012F,0136,013D,0144,014B,0167
	ldaa	$00,x
	tsta
	bne	LAF3F
	ldab	#$20
	orab	X018C
	stab	X018C	; set bit5
	bra	LAF47
;
LAF3F:
	ldaa	#$08
	oraa	X018C
	staa	X018C	; set bit3
LAF47:
	jsr	sub019
	jmp	LB213
;
LAF52:
	ldaa	#$25
	ldab	#$01
	adda	X0790
	adcb	#$00
	staa	x0049
	stab	x0048
	ldx	x0048		; possible locations 012F,0136,013D,0144,014B,0167
	ldaa	$00,x
	tsta
	bne	LAF6D
	ldab	#$2B	; ASCII "+"
	stab	MeasPolaritySign
	bra	LAF72
;
LAF6D:
	ldaa	#$2D	; ASCII "-"
	staa	MeasPolaritySign
LAF72:
	jsr	subPackReading
	ldaa	flagOverrange_Maybe
	tsta
	bne	LAF86
	ldab	#$20
	andb	X0791
	tstb
	bne	LAF86
	jsr	subStoreReading
LAF86:
	ldaa	#$1F
	anda	X0791
	staa	X01CC	; lower 5 bits of x0791, possible range 0-24?
LAF8E:
	clr	X01CF
	ldaa	X01CC
	cmpa	#$15
	bls	LAFA0
	ldab	#$80
	orab	X0791
	stab	X0791	; set bit7
LAFA0:
	ldaa	MeasArray7
	cmpa	#$01
	bne	LAFBD	; branch if leading digit != 1
	ldab	#$64
	ldaa	#$F6	; table values @ F664
	addb	X01CC
	adca	#$00
	stab	x004B
	staa	x004A
	ldx	x004A
	ldaa	$00,x
	staa	X01A4	; 28-21, 00-10?
	bra	LAFD1

; data in original file
;F664 : 28 27 26
;F667 : 25 24 23 22
;F66B : 21 00 01 02
;F66F : 03 04 05 06
;F673 : 07 08 09 0A
;F677 : 0B 0C 0D 0E
;F67B : 0F 10 29 28

;F67D : 29 28
;F67F : 27 26 25 24
;F683 : 23 22 21 00
;F687 : 01 02 03 04
;F68B : 05 06 07 08
;F68F : 09 0A 0B 0C
;F693 : 0D 0E 0F 19
;
LAFBD:
	ldaa	#$7D
	ldab	#$F6	; table values @ F67D
	adda	X01CC
	adcb	#$00
	staa	x0049
	stab	x0048
	ldx	x0048
	ldaa	$00,x
	staa	X01A4	; 29-21, 00-0F?
LAFD1:
	ldaa	#$2B	; ASCII "+"
	cmpa	MeasExponentSign
	bne	LAFF4	; branch if not +
	ldab	#$20
	andb	X01A4
	tstb
	bne	LAFF2	; branch if 01A4 < 20
	ldab	#$1F
	andb	X01A4	; lower 5 bits
	cmpb	MeasExponent
	bcs	LAFF2
	ldab	#$40
	orab	X0791
	stab	X0791	; set bit6
LAFF2:
	bra	LB026
;
LAFF4:
	ldaa	#$2D	; ASCII "-"
	cmpa	MeasExponentSign
	bne	LB026	; branch if not -
	ldab	#$20
	andb	X01A4
	tstb
	bne	LB00B	; branch if 01A4 < 20
	ldab	#$40
	orab	X0791
	stab	X0791	; set bit6
LB00B:
	ldaa	#$20
	anda	X01A4
	cmpa	#$20
	bne	LB026	; branch if 01A4 < 20
	ldaa	#$1F
	anda	X01A4	; lower 5 bits
	cmpa	MeasExponent
	bhi	LB026	; branch if higher
	ldaa	#$40	; if less or equal, set bit6
	oraa	X0791
	staa	X0791
LB026:
	ldaa	#$40
	anda	X0791
	tsta
	beq	LB098	; branch if bit6 = 0
	ldaa	#$96
	ldab	#$F6	; table values @ F696
	adda	X01CC	; possible range 0-24?
	adcb	#$00
	staa	x004D
	stab	x004C
	ldx	x004C
	ldaa	$00,x
	staa	X01CD
	ldaa	#$2B	; ASCII "+"
	clrb
	cmpa	MeasExponentSign
	bne	LB04B
	decb
LB04B:			; B = 00 if sign != +, else FF
	ldaa	#$1F
	anda	X01CD	; possible results 00,03,06,09,13,16,19
	stab	x0048
	clrb
	cmpa	#$10
	bls	LB058
	decb
LB058:
	andb	x0048
	tstb
	beq	LB07F
LB05D:
	ldaa	#$2B	; ASCII "+"
	cmpa	MeasExponentSign
	bne	LB0AE
	dec	MeasExponent
	inc	X01CF
	ldaa	MeasExponent
	tsta
	bne	LB07B
	inc	MeasExponent
	ldaa	#$2D	; ASCII "-"
	staa	MeasExponentSign
	inc	X01CF
LB07B:
	bra	LB05D
LB098:
	inc	X01CC
	jmp	LAF8E
;
;F696 :  19
;F697 : 39 59 79 36
;F69B : 56 76 33 53
;F69F : 00 20 40 60
;F6A3 : 23 43 63 26
;F6A7 : 46 66 29 49
;F6AB : 69 89 A9 C9
;
;
LB07F:
	ldaa	#$2D	; ASCII "-"
	cmpa	MeasExponentSign
	bne	LB0AE
	ldab	#$1F
	andb	X01CD
	cmpb	#$10
	bcc	LB0AE
LB08F:
	ldaa	#$2D	; ASCII "-"
	cmpa	MeasExponentSign
	bne	LB0AE
	dec	MeasExponent
	inc	X01CF
	ldaa	MeasExponent
	tsta
	bne	LB0AC
	ldab	#$2B	; ASCII "+"
	stab	MeasExponentSign
LB0AC:
	bra	LB08F
;
LB0AE:
	ldaa	#$0F
	anda	X01CD
	staa	X01CD
	ldaa	#$2D	; ASCII "-"
	cmpa	MeasExponentSign
	bne	LB0D5
	ldab	X01CD
	stab	X01A4
	ldaa	MeasExponent
	staa	X01A5
	ldaa	MeasExponent
	staa	X01CD
	ldaa	X01A4
	staa	MeasExponent
LB0D5:
	ldaa	MeasExponent
	cmpa	X01CD
	bls	LB0E7
	ldab	#$40
	orab	X0791
	stab	X0791
	bra	LB0EF
;
LB0E7:
	ldaa	#$BF
	anda	X0791
	staa	X0791
LB0EF:
	ldaa	MeasExponent
	cmpa	X01CD
	bls	LB0FF
	dec	MeasExponent
	inc	X01CF
	bra	LB0EF
;
LB0FF:
	ldaa	MeasExponent
	cmpa	X01CD
	bcc	LB10F
	inc	MeasExponent
	inc	X01CF
	bra	LB0FF
;
LB10F:
	ldaa	#$96
	ldab	#$F6	; table values @ F696
	adda	X01CC
	adcb	#$00
	staa	x0049
	stab	x0048
	ldx	x0048
	ldaa	$00,x
	anda	#$0F
	staa	MeasExponent
	ldaa	#$96
	ldab	#$F6	; table values @ F696
	adda	X01CC
	adcb	#$00
	staa	x0049
	stab	x0048
	ldx	x0048
	ldaa	$00,x
	lsra
	lsra
	lsra
	lsra
	lsra
	staa	X01CE
	inc	X01CE
	ldaa	#$40
	anda	X0791
	tsta
	beq	LB1B5
	ldaa	#$07
	suba	X01CF
	staa	X01CD
	clr	X01A5
LB154:
	ldaa	X01CD
	tsta
	beq	LB184
	ldab	#$D1
	ldaa	#$01	; base address of MeasArray
	addb	X01A5
	adca	#$00
	stab	x004B
	staa	x004A
	ldaa	X01A5
	inca
	clrb
	adda	#$D1
	adcb	#$01	; base address of MeasArray
	staa	x004F
	stab	x004E
	ldx	x004E
	ldaa	$00,x
	ldx	x004A
	staa	$00,x
	inc	X01A5
	dec	X01CD
	bra	LB154
;
LB184:
	ldaa	#$D1
	ldab	#$01	; base address of MeasArray
	adda	X01A5
	adcb	#$00
	staa	x0049
	stab	x0048
	ldaa	#$2E	; ASCII "."
	ldx	x0048
	staa	$00,x
	ldaa	X01CE
	suba	X01CF
	staa	X01A4
LB1A0:
	ldaa	X01A4
	tsta
	beq	LB1E5
	jsr	subShiftMeasArrayRight
	dec	X01A4
	bra	LB1A0
;
LB1B5:
	ldaa	X01CF
	inca
	staa	X01CD
LB1BC:
	ldaa	X01CD
	tsta
	beq	LB1CA
	jsr	subShiftMeasArrayRight
	dec	X01CD
	bra	LB1BC
;
LB1CA:
	ldaa	#$2E	; ASCII "."
	staa	MeasArray7
LB1CF:
	ldaa	X01CE
	tsta
	beq	LB1E5
	jsr	subShiftMeasArrayRight
	dec	X01CE
	bra	LB1CF
;
LB1E5:
	ldaa	flagHPIBPackedOutput
	tsta
	bne	LB1EE
	jsr	subFormatReadingForHPIB
LB1EE:
	ldaa	#$01
	staa	flagMeasArrayUnpacked
	ldaa	#$20
	anda	X0791
	tsta
	beq	LB213
	ldaa	MeasExponent
	tsta
	bne	LB206
	clr	flagMeasHasExponent
	bra	LB20B
LB206:
	ldaa	#$01
	staa	flagMeasHasExponent
LB20B:
	jsr	subCopyMeas2DispBytes
	ldaa	#$01
	staa	flagMeasFormatted
LB213:
	clr	X0790
	ldaa	X0791
	staa	X019C
	clra
	clrb
	rts
;---------------------------------

subUpdateHPIBSerialPoll:
	ldaa	HPIBSerialPollMask	; possible values FB, FD, FE, i.e., turn off bit6, 5 or 4
	anda	ioHPIB_r5	; serial poll register, used to give meter status on HPIB
	staa	x01CA
	ldaa	#$40
	cmpa	x01CA
	bne	LB23E		; branch if HPIB service requested
	clr	ioHPIB_r5
	ldaa	#$EF
	anda	flagHPIBOutput
	staa	flagHPIBOutput	; clear bit4
	bra	LB247
;
LB23E:
	ldaa	HPIBSerialPollMask
	anda	ioHPIB_r5
	staa	ioHPIB_r5	; update status info given to bus
LB247:
	clra
	clrb
	rts
;---------------------------------
; called if the inguard has timed out, i.e., inguard did not respond fast enough
subHandleIGTimeout:
	ldaa	flagInguard1stTimeout
	tsta
	bne	LB271
	ldab	#$10
	stab	HPIBSerialPollStatus
	jsr	subHPIBRequestService
	ldaa	#$01
	staa	flagInguard1stTimeout
	ldaa	#$F7
	anda	flagCmdParse
	staa	flagCmdParse	; clear bit3
	ldaa	#$01
	staa	flagHPIBByteInIntr
	jmp	LD421		; jumps into sub103 if 2nd timeout occurs

LB271:				; if it was the 1st timeout, try again
	clr	ioIOreset
	ldaa	#$FF
	staa	ioIsoLogic
	ldaa	#$B0
	ldab	#$04
	psha
	pshb
	ldaa	#$01
	psha		; 01, 04, B0 on stack
	jsr	subProgrammedDelay
	ldaa	#$8F
	staa	ioIsoLogic
	ldaa	#$20	; ASCII " "
	ldab	#$4E
	psha
	pshb
	ldaa	#$01
	psha		; 01, 4E, 20 on stack
	jsr	subProgrammedDelay
	clr	flagInguard1stTimeout
	ldaa	#$F7
	anda	flagCmdParse
	staa	flagCmdParse	; clear bit3
	ldaa	#$01
	staa	flagHPIBByteInIntr
	jmp	LD421		; jumps into sub103
LB2A9:
	rts
;---------------------------------

sub026:
	ldaa	#$0F
	staa	MeasArray7
	staa	MeasPolaritySign
	ldaa	#$0A	; puts dashes on display
	staa	MeasArray0
	staa	MeasArray1
	staa	MeasArray2
	staa	MeasArray3
	staa	MeasArray4
	staa	MeasArray5
	staa	MeasArray6

	staa	Digit7	;***** MODDED put a dash in exponent digit, too

	ldaa	#$D1
	ldab	#$01	; base address of MeasArray
	adda	DecimalPosition
	adcb	#$00
	staa	x0049
	stab	x0048
	ldaa	#$2E	; ASCII "."
	ldx	x0048
	staa	$00,x	; inserts decimal point
	jsr	sub016	; returns InguardStatus bit3-0 or 5 in DecimalDisplayPosition
	ldaa	#$01
	staa	flagMeasArrayUnpacked
	jsr	subCopyMeas2DispBytes
	clr	flag010B
	rts
;---------------------------------

sub027:
	ldaa	#$80
	anda	IGCmdRegister2	; IGCmdRegister2 bit 7 determines if EOI added to HPIB output
	tsta
	beq	LB2FE
	ldaa	#$01
	staa	flagOutputEOI
	bra	LB301
;
LB2FE:
	clr	flagOutputEOI
LB301:				; flagOutputEOI = 01 if IGCmdRegister2 bit7 = 1, else 00
	ldaa	#$20
	anda	IGCmdRegister4	; IGCmdRegister4 bit 5 determines if output is in packed format
	tsta
	beq	LB310
	ldaa	#$01
	staa	flagHPIBPackedOutput
	bra	LB313
;
LB310:
	clr	flagHPIBPackedOutput
LB313:				; flagHPIBPackedOutput = 01 if IGCmdRegister4 bit5 = 1, else 00
	ldaa	#$10
	anda	IGCmdRegister4	; IGCmdRegister4 bit 4 sets display to update
	tsta
	beq	LB322
	ldaa	#$01
	staa	flagDispNeedUpdate
	bra	LB325
;
LB322:
	clr	flagDispNeedUpdate
LB325:				; flagDispNeedUpdate = 01 if IGCmdRegister4 bit4 = 1, else 00
	ldaa	#$E0
	anda	IGCmdRegister0
	lsra
	lsra
	lsra
	lsra
	staa	X078A			; X078A is bit7-5 of IGCmdRegister0 in bit3-1
	ldaa	#$0E
	anda	IGCmdRegister0
	lsra
	staa	X078C			; X078C is bit3-1 of IGCmdRegister0 in bit2-0 -> max value 7
	ldaa	#$07
	anda	IGCmdRegister1
	staa	flagNumPLCcode	; bit2-0
	jsr	sub016			; returns InguardStatus bit3-0 or 5 in DecimalDisplayPosition
	ldaa	DecimalDisplayPosition
	staa	DecimalPosition
	ldaa	#$01
	staa	X019D
	ldaa	IGCmdRegister0
	lsra
	lsra
	lsra
	lsra
	staa	x011C
	ldaa	x011C
	suba	#$02
	staa	x011C	; = IGCmdRegister0 >> 4 - 2, max value is 13(dec)
	ldaa	#$7B
	ldab	#$F7
	adda	x011C
	adcb	#$00
	staa	x0049
	stab	x0048
	ldx	x0048
	ldaa	$00,x
	; table F77B
	; index		0	1	2	3	4	5	6	7	8	9	10	11	12	13
	; return	0C 	0C 	0C 	0C	04 	04 	07 	07	07 	03 	07 	03	10 	10
	staa	X011E
	ldaa	X011E
	lsra
	lsra
	lsra
	anda	#$07
	staa	X0199
	ldaa	#$07
	anda	X011E
	staa	X019A
	ldaa	#$6F
	ldab	#$F7
	adda	x011C
	adcb	#$00
	staa	x0049
	stab	x0048
	ldx	x0048
	ldaa	$00,x
	; table F76F
	; index		0	1	2	3	4	5	6	7	8	9	10	11	12	13
	; return81 	86 	81 	86	01 	06 	40 	40	11 	1A 	11 	1A	0C 	0C
	staa	X0198
	ldaa	#$18
	anda	X0198
	cmpa	#$10
	bne	LB3D7		; branch if bit4 = 1
	ldaa	#$06
	cmpa	X078C
	bne	LB3C1
	ldab	#$20
	orab	X0198
	andb	#$FE
	stab	X0198		; set bit5, clear bit0
	ldaa	#$04
	staa	DecimalPosition
LB3C1:
	ldaa	#$07
	cmpa	X078C
	bne	LB3D7
	ldab	#$03
	stab	DecimalPosition
	ldaa	#$20
	oraa	X0198
	anda	#$FE
	staa	X0198		; set bit5, clear bit0
LB3D7:
	ldaa	#$0F
	anda	IGCmdRegister2
	clrb
	tsta
	beq	LB3E1
	decb
LB3E1:				; B = FF if IGCmdRegister2 lower nibble != 00, else 00
	ldaa	IGCmdRegister0
	anda	#$01
	stab	x004A
	clrb
	tsta
	beq	LB3ED
	decb
LB3ED:				; B = FF if IGCmdRegister0 bit0 != 1, else 00
	orab	x004A
	rorb
	bcc	LB3FA		; branch if IGCmdRegister2 lower nibble = 00 and IGCmdRegister0 bit0 = 1
	ldaa	#$FE
	anda	X0198
	staa	X0198		; clear bit0
LB3FA:
	ldaa	#$10
	anda	X0198
	tsta
	beq	LB40C		; branch if X0198 bit4 = 0
	ldaa	#$03
	adda	X078C
	staa	X019B
	bra	LB412
;
LB40C:
	ldaa	X078C
	staa	X019B
LB412:				; if X0198 bit4 = 0, X019B = X078C, else = X078C + 3
	rts
;---------------------------------

sub028:
	jsr	sub027
	ldaa	#$08
	adda	X019B
	staa	X019C
	ldaa	X019C
	staa	X01A9		; X01A9 = X019C = X019B + 8
	ldaa	#$D1
	anda	X018C
	staa	X018C		; clear bits 5,3-1
	clr	flagOverrange_Maybe
	ldaa	#$45		; ASCII "E"
	staa	FormattedReading9
	ldaa	#$0D		; ASCII [cr]
	staa	FormattedReading12
	ldaa	#$0A		; ASCII [lf]
	staa	FormattedReading13
	ldaa	X012A
	staa	X018F
	ldaa	X012B
	staa	X018E		; X018E,F = X012A,B
	ldaa	#$08
	oraa	flagCmdParse
	staa	flagCmdParse	; set bit3
	rts
;---------------------------------
; puts "Ex" on the display, where x is the error number
; imports error number in ErrorNumber
subDisplayError:
	clr	flagX01FB
	clr	flagCmdParse
	clr	tempCmdParseFlag
	clr	flag01A1
	ldaa	#$40
	anda	ioHPIB_r1	; bit6 set if meter in HPIB Remote mode
	tsta
	beq	LB473		; branch if not in Remote mode
	ldaa	#$10
	staa	HPIBSerialPollStatus
	jsr	subHPIBRequestService
LB473:
	jsr	subBlankMeasArray
	clr	flagMeasArrayUnpacked
	ldaa	#$0B		; display "E"
	staa	MeasArray2
	ldaa	#$0F
	anda	ErrorNumber		; possible values 1,2,3,5,6 Error Number
	staa	MeasArray1
	jsr	subCopyMeas2DispBytes
	jmp	LC9D2
;---------------------------------

subDisplayError4:
	ldaa	#$04
	staa	ErrorNumber
	bsr	subDisplayError
	rts
;---------------------------------
; Measurement is in AccumRegister, in register format. Perhaps this detects overrange?  Sets flagOverrange
; only called when in Auto range
subTestForOverrange_Maybe:
	ldaa	X019B		; something to do with the exponent range?
	cmpa	AccumRegister6	; is either MeasExponent or its compliment
	bne	LB4D6		; branch if exponent not flagOverrange_Maybe
	ldab	AccumRegister2	; contains digits 2 and 3
	lsrb
	lsrb
	lsrb
	lsrb			; B = digit2
	ldaa	AccumRegister1	; digit1
	stab	x004A		; digit2 in lower nibble
	clrb
	cmpa	#$01
	bne	LB4B2		; branch if digit1 != 1, i.e., must be 0
	decb
LB4B2:
	ldaa	x004A		; A = digit2
	stab	x004C		; = FF if digit1 = 1, else 00
	clrb
	cmpa	X019D		; X019D = 0 or 1
	bls	LB4BD		; branch if digit2 is <= 0 or 1 (X019D)
	decb
LB4BD:				; B = FF if digit2 is > 0 or 1 (X019D)
	andb	x004C		; B = FF if digit1 = 1 and digit2 > 0 or 1 (X019D)  maybe overrange indication?
	ldaa	AccumRegister1	; digit1
	stab	x0050
	clrb
	cmpa	#$01
	bls	LB4CA		; branch if digit1 = 0 or 1
	decb
LB4CA:				; B = FF if digit1 >= 2
	orab	x0050		; B = FF if (digit1 = 1 and digit2 > 0 or 1 (X019D)) or digit1 >= 2
	rorb
	bcc	LB4D4
	ldab	#$01
	stab	flagOverrange_Maybe	; set flag if (digit1 = 1 and digit2 > 0 or 1 (X019D)) or digit1 >= 2
LB4D4:
	rts
;
LB4D6:				 ; arrive here if exponent != flagOverrange_Maybe
	ldaa	#$80
	anda	AccumRegister6
	tsta
	bne	LB4EB		; branch to rts if exponent < 0
	ldaa	AccumRegister6
	cmpa	X019B
	bls	LB4EB		; branch to rts if exponent <= flagOverrange_Maybe
	ldab	#$01
	stab	flagOverrange_Maybe	; must be set if exponent > flagOverrange_Maybe
LB4EB:
	rts
;---------------------------------
; copies 7 byte register AccumRegister (0167-016D) to another register.  Given offset (X0793)
; to last byte of register to copy to and copies from last to first bytes.
subCopyAccumRegToRegister:
	clr	x01B0	; loop index
LB4F1:
	ldaa	x01B0
	cmpa	#$06
	bhi	LB522	; rts when = 7
	ldaa	X0793	; parameter from calling sub, values 1E,25,2C,49,57,65
	suba	x01B0	; subtract index 0-6
	clrb
	adda	#$25
	adcb	#$01
	staa	x004B
	stab	x004A
	ldaa	#$48
	suba	x01B0
	clrb
	adda	#$25
	adcb	#$01
	staa	x004F
	stab	x004E
	ldx	x004E	; 16D-167  <-- copies from this register
	ldaa	$00,x
	ldx	x004A	; 143-13D,14A-144,151-14B,16E-168,17C-176,18A-184  <-- to one of these
	staa	$00,x
	inc	x01B0
	bra	LB4F1
LB522:
	rts
;---------------------------------
; returns with AccumRegister = AccumRegister / (1.0E7 - AccumRegister), unless denominator
; is < 1E-9, then no change to AccumRegister and flagOverrange_Maybe = 1
sub033:
	ldaa	#$57
	staa	X0793
	bsr	subCopyAccumRegToRegister	; copies to 0176-017C
	clr	X0176
	ldaa	#$D3
	ldab	#$F7		; F7D3 = 00 01 00 00 00 00 08 = 1.0E+7
	psha
	pshb
	ldaa	#$76
	ldab	#$01
	psha
	pshb
	ldaa	#$E6
	ldab	#$01
	psha
	pshb
	ldaa	#$03
	psha
	jsr	subRegisterSubtract	; 01E6 =  F7D3(= 1.0E+7) - 0176
	ldaa	X01E7			; first byte of mantissa
	tsta
	beq	LB56F			; testing if subtraction result magnitude is too small?
	ldab	#$07
	addb	AccumRegister6
	stab	AccumRegister6
	ldaa	#$67
	ldab	#$01			; 0167 = base address of AccumRegister
	psha
	pshb
	ldaa	#$E6
	ldab	#$01
	psha
	pshb
	ldaa	#$67
	ldab	#$01
	psha
	pshb
	ldaa	#$03
	psha
	jsr	subRegisterDivide	; 0167 = 0167 / 01E6
	bra	LB574
;
LB56F:
	ldaa	#$01
	staa	flagOverrange_Maybe
LB574:
	rts
;---------------------------------

sub034:
	ldaa	#$67
	ldab	#$01			; 0167 = base address of AccumRegister
	psha
	pshb
	ldaa	#$76
	ldab	#$01
	psha
	pshb
	ldaa	#$67
	ldab	#$01
	psha
	pshb
	ldaa	#$03
	psha
	jsr	subRegisterSubtract	; 0167 = 0167 - 0176
	rts
;---------------------------------

sub035:
	ldaa	#$08
	oraa	X018C
	staa	X018C		; set bit3
	ldaa	#$01
	staa	AccumRegister1
	ldaa	#$11
	staa	AccumRegister6
	rts
;---------------------------------

sub036:
	ldaa	#$20
	oraa	X018C
	staa	X018C		; set bit5
	ldaa	#$01
	staa	AccumRegister1
	ldaa	#$11
	staa	AccumRegister6
	rts
;---------------------------------

subClearAccumRegister:
	clr	AccumRegister0
	clr	AccumRegister1
	clr	AccumRegister2
	clr	AccumRegister3
	clr	AccumRegister4
	clr	AccumRegister5
	clr	AccumRegister6
	rts
;---------------------------------

sub038:
	ldaa	AccumRegister6	; measurement exponent, 2's compliment if negative
	staa	x01B0
	ldaa	#$80
	anda	x01B0
	tsta
	beq	LB5EA		; branch if bit7 = 0, ie, x01B0 is positive
	ldaa	x01B0
	coma			; 1's compliment
	inca			; 2's compliment
	staa	x01B0
LB5EA:
	ldaa	x01B0		; absolute value of exponent
	cmpa	#$1F		; 3456A manual, paragraph 3-74 says exponent can be up to +/-9
	bls	LB5F4
	jmp	LB67E
;
LB5F4:
	clr	AccumRegister0
	ldaa	AccumRegister1
	tsta
	bne	LB600
	jmp	LB682
;
LB600:
	ldaa	#$49
	staa	X0793
	jsr	subCopyAccumRegToRegister	; copies to 0168-016E
	ldx	#$0169
	stx	IdxPtr0169
	ldx	#$0174
	stx	IdxPtr0174
	ldaa	#$FF
	staa	RegisterSTAT30
	clr	RegisterSTAT31
	clr	RegisterSTAT32
	clr	RegisterSTAT33
	clr	RegisterSTAT34
	clr	RegisterSTAT35
	clr	RegisterSTAT36
	clra
	psha		; push 00 on stack
	jsr	subMath22	;
	sts	x0048
	ldaa	x0049
	ldab	x0048
	adda	#$01
	adcb	#$00
	staa	x004B
	stab	x004A
	lds	x004A	; increment stack pointer to get rid of the 00 pushed on?
	jsr	subClearAccumRegister
	clra
	psha		; push 00 on stack
	jsr	sub158	; does not use stack
	sts	x0048	; stack pointer
	ldaa	x0049
	ldab	x0048
	adda	#$01
	adcb	#$00
	staa	x004B
	stab	x004A
	lds	x004A	; increment stack pointer to get rid of the 00 pushed on?
	ldaa	#$0F
	anda	RegisterSTAT31
	staa	RegisterSTAT31
	ldaa	#$6F
	ldab	#$01
	psha
	pshb
	ldaa	#$68
	ldab	#$01
	psha
	pshb
	ldaa	#$67
	ldab	#$01		; 0167 = base address of AccumRegister
	psha
	pshb
	ldaa	#$03
	psha
	jsr	subRegisterAdd	; 0167 = 016F + 0168
	rts
;
LB67E:
	jsr	sub036
	rts
;
LB682:
	jsr	sub035
	rts
;===============================================================================
; (X - Y)/Y function
sub039:
	ldaa	#$67
	ldab	#$01			; 0167 = base address of AccumRegister
	psha
	pshb
	ldaa	#$3D
	ldab	#$01
	psha
	pshb
	ldaa	#$B1
	ldab	#$01
	psha
	pshb
	ldaa	#$03
	psha
	jsr	subRegisterSubtract	; 01B1 = 0167 - 013D
	ldaa	RegisterY1		; byte 1 of Y register
	tsta
	bne	LB6A9
	jmp	LB6CB		; jump to avoid divide by zero
;
LB6A9:
	ldaa	#$B1
	ldab	#$01
	psha
	pshb
	ldaa	#$36
	ldab	#$01
	psha
	pshb
	ldaa	#$67
	ldab	#$01			; 0167 = base address of AccumRegister
	psha
	pshb
	ldaa	#$03
	psha
	jsr	subRegisterDivide		; 0167 = 01B1 / 0136
	ldaa	X019C
	suba	RegisterY6	; constant at 01
	staa	X019C
	rts
;
LB6CB:
	ldaa	X01B1
	tsta
	bne	LB6D6
	jsr	sub036
	bra	LB6D9
;
LB6D6:
	jsr	sub035
LB6D9:
	rts
;===============================================================================
; 100(X - Y)/Y function
sub040:
	ldaa	#$67
	ldab	#$01		; 0167 = base address of AccumRegister
	psha
	pshb
	ldaa	#$36
	ldab	#$01
	psha
	pshb
	ldaa	#$D1
	ldab	#$01	; base address of MeasArray
	psha
	pshb
	ldaa	#$03
	psha
	jsr	subRegisterSubtract	;  01D1 = 0167 - 0136
	ldaa	RegisterY1	; byte 1 of Y register
	tsta
	bne	LB6FD
	jmp	LB723		; jump to avoid divide by zero
;
LB6FD:
	ldaa	#$D1
	ldab	#$01	; base address of MeasArray
	psha
	pshb
	ldaa	#$36
	ldab	#$01
	psha
	pshb
	ldaa	#$67
	ldab	#$01
	psha
	pshb
	ldaa	#$03
	psha
	jsr	subRegisterDivide		; 0167 = 01D1 / 0136
	ldaa	#$02
	adda	AccumRegister6
	staa	AccumRegister6		; add 2 to exponent, --> x 100
	ldaa	#$0B
	staa	X019C
	rts

;
LB723:
	ldaa	MeasArray0
	tsta
	bne	LB72E
	jsr	sub036
	bra	LB731
;
LB72E:
	jsr	sub035
LB731:
	rts
;===============================================================================
; Null function
sub041:
	ldaa	X018C
	anda	#$01
	cmpa	#$01
	bne	LB74D
	ldaa	#$1E
	staa	X0793
	jsr	subCopyAccumRegToRegister	; copies to 013D-0143
	ldaa	#$FE
	anda	X018C
	staa	X018C	; clear bit0
LB74D:
	ldaa	#$67
	ldab	#$01			; 0167 = base address of AccumRegister
	psha
	pshb
	ldaa	#$3D
	ldab	#$01
	psha
	pshb
	ldaa	#$67
	ldab	#$01
	psha
	pshb
	ldaa	#$03
	psha
	jsr	subRegisterSubtract	; 0167 = 0167 - 013D
	rts
;===============================================================================
; preload LOWER and UPPER register 7 byte data arrays
subPresetLnUregs:
	ldaa	#$01
	staa	RegisterL1
	staa	RegisterU1
	clr	RegisterU0
	clr	RegisterL5
	clr	RegisterU5
	ldaa	#$FF
	staa	RegisterL0
	ldaa	#$10
	staa	RegisterL6
	staa	RegisterU6	; FIX: was RegisterU5; exponent byte of U = +1.999999E9
	ldaa	#$99
	staa	RegisterL2
	staa	RegisterL3
	staa	RegisterL4
	staa	RegisterU2
	staa	RegisterU3
	staa	RegisterU4
	rts
;===============================================================================

sub043:
	ldaa	X018C
	anda	#$01
	rora
	bcc	LB80C	; branch if bit0 is 0
	ldaa	#$0F
	anda	IGCmdRegister2
	cmpa	#$02
	bne	LB80C
	ldaa	#$25
	staa	X0793
	jsr	subCopyAccumRegToRegister	; copies current measurement to 0144-014A
	ldaa	#$2C
	staa	X0793
	jsr	subCopyAccumRegToRegister	; copies current measurement to 014B-0151
	ldaa	#$65
	staa	X0793
	jsr	subCopyAccumRegToRegister	; copies current measurement to 0184-018A
	ldaa	#$1E
	staa	X0793
	jsr	subCopyAccumRegToRegister	; copies current measurement to 013D-0143

	ldaa	#$2D
	staa	x01B0
LB7D3:
	ldaa	x01B0
	cmpa	#$41		; loop from 2D to 41
	bhi	LB7F0
	ldaa	#$25
	ldab	#$01
	adda	x01B0
	adcb	#$00
	staa	x0049
	stab	x0048
	ldx	x0048
	clr	$00,x		; clears memory from 0152 to 166
	inc	x01B0
	bra	LB7D3

LB80C:
	rts
;
LB7F0:
	clr	X010E		; then clear all these
	clr	X010F
	clr	X0110
	clr	X0111
	clr	X0112
	clr	X0113
	clr	X0114
	clr	X0108
	ldaa	#$FE
	anda	X018C
	staa	X018C	; clear bit0
	rts
;===============================================================================
; Statistics function
subMathFcnStats:
	ldaa	#$10
	anda	X018C
	tsta
	beq	LB82B	; branch if bit4 = 0
	rts
;
LB82B:
	ldaa	flagOverrange_Maybe
	clrb
	tsta
	beq	LB833
	decb
LB833:
	ldaa	#$28
	anda	X018C
	stab	x0048	; keep bits 5,3
	clrb
	tsta
	beq	LB83F
	decb
LB83F:
	orab	x0048
	rorb
	bcc	LB855
	ldaa	#$10
	oraa	X018C
	anda	#$FE
	staa	X018C	; set bit4, clear bit0
	jsr	subPresetLnUregs
	clr	RegisterC1
	rts
;
LB855:
	ldaa	#$10
	staa	ioHPIB_r0	; turn off interrupts from HPIB
	sei
	jsr	sub043
	ldaa	#$5D
	ldab	#$F6		; F65D = 00 01 00 00 00 00 01
	psha
	pshb
	ldaa	#$52
	ldab	#$01
	psha
	pshb
	psha
	pshb
	ldaa	#$03
	psha
	jsr	subRegisterAdd	; 0152 = F65D (= 1) + 0152
	inc	X0108
	ldaa	#$67
	ldab	#$01			; 0167 = base address of AccumRegister
	psha
	pshb
	ldaa	#$84
	ldab	#$01
	psha
	pshb
	ldaa	#$6F
	ldab	#$01
	psha
	pshb
	ldaa	#$03
	psha
	jsr	subRegisterSubtract	; 016F = 0167 - 0184
	ldaa	#$60
	ldab	#$01
	psha
	pshb
	ldaa	#$6F
	ldab	#$01
	psha
	pshb
	ldaa	#$60
	ldab	#$01
	psha
	pshb
	ldaa	#$03
	psha
	jsr	subRegisterAdd	; 0160 = 0160 + 016F
	ldaa	#$6F
	ldab	#$01
	psha
	pshb
	psha
	pshb
	psha
	pshb
	ldaa	#$03
	psha
	jsr	subRegisterMultiply	; 016F = 016F * 016F
	ldaa	#$6F
	ldab	#$01
	psha
	pshb
	ldaa	#$59
	ldab	#$01
	psha
	pshb
	psha
	pshb
	ldaa	#$03
	psha
	jsr	subRegisterAdd	; 0159 = 016F + 0159
	ldaa	#$41
	ldab	#$03
	eora	X0108
	staa	X0002
	orab	X0002
	bne	LB90B
	ldaa	#$0E
	ldab	#$01
	psha
	pshb
	ldaa	#$60
	ldab	#$01
	psha
	pshb
	ldaa	#$0E
	ldab	#$01
	psha
	pshb
	ldaa	#$03
	psha
	jsr	subRegisterAdd	; 010E = 010E + 0160
	clr	RegisterSTAT20
	clr	RegisterSTAT21
	clr	RegisterSTAT22
	clr	RegisterSTAT23
	clr	RegisterSTAT24
	clr	RegisterSTAT25
	clr	RegisterSTAT26
	clr	X0108
LB90B:
	ldaa	#$44
	ldab	#$01
	psha
	pshb
	ldaa	#$67
	ldab	#$01
	psha
	pshb
	ldaa	#$D1
	ldab	#$01		; base address of MeasArray
	psha
	pshb
	ldaa	#$03
	psha
	jsr	subRegisterSubtract	; 01D1 = 0144 - 0167
	ldaa	MeasArray0
	tsta
	bne	LB933
	ldab	#$25
	stab	X0793
	jsr	subCopyAccumRegToRegister	; copies current measurement to 0144-014A
	bra	LB959
;
LB933:
	ldaa	#$67
	ldab	#$01
	psha
	pshb
	ldaa	#$4B
	ldab	#$01
	psha
	pshb
	ldaa	#$D1
	ldab	#$01		; base address of MeasArray
	psha
	pshb
	ldaa	#$03
	psha
	jsr	subRegisterSubtract	; 01D1 = 0167 - 014B
	ldaa	MeasArray0
	tsta
	bne	LB959
	ldab	#$2C
	stab	X0793
	jsr	subCopyAccumRegToRegister	; copies current measurement to 014B-0151
LB959:
	cli
	ldaa	#$A5
	staa	ioHPIB_r0	; turn on interrupts from HPIB
	rts
;===============================================================================
; dBm function
subMathFcnDBM:
	ldaa	RegisterR1	; FIX: was RegisterZ1; dBm divides by R (ref. impedance)
	tsta
	bne	LB96B
	jmp	LB9BB
;
LB96B:
	ldaa	#$67
	ldab	#$01			; 0167 = base address of AccumRegister
	psha
	pshb
	psha
	pshb
	ldaa	#$B1
	ldab	#$01
	psha
	pshb
	ldaa	#$03
	psha
	jsr	subRegisterMultiply	; 01B1 = 0167 * 0167
	ldaa	#$B1
	ldab	#$01
	psha
	pshb
	ldaa	#$2F
	ldab	#$01
	psha
	pshb
	ldaa	#$67
	ldab	#$01
	psha
	pshb
	ldaa	#$03
	psha
	jsr	subRegisterDivide	; 0167 = 01B1 / 012F
	jsr	sub038
	ldaa	#$67
	ldab	#$01
	psha
	pshb
	ldaa	#$2E
	ldab	#$F9	; F92E = 00 03 00 00 00 00 01 (=3.0)
	psha
	pshb
	ldaa	#$67
	ldab	#$01
	psha
	pshb
	ldaa	#$03
	psha
	jsr	subRegisterAdd	; 0167 = 0167 + F92E (=3.0)
	inc	AccumRegister6
	ldaa	#$0C
	staa	X019C
	rts

LB9BB:
	jsr	sub036
	rts
;===============================================================================

sub046:
	ldaa	#$80
	staa	HPIBSerialPollStatus
	jsr	subHPIBRequestService
	rts
;===============================================================================
; Pass/Fail function
subMathFcnPassFail:
	ldaa	flagOverrange_Maybe
	clrb
	tsta
	beq	LB9D4
	decb
LB9D4:
	ldaa	#$28
	anda	X018C
	stab	x0048	; keep bits 3,5
	clrb
	tsta
	beq	LB9E0
	decb
LB9E0:
	orab	x0048
	rorb
	bcc	LB9E9
	bsr	sub046
	bra	LBA41
;
LB9E9:
	ldaa	#$67
	ldab	#$01			; 0167 = base address of AccumRegister
	psha
	pshb
	ldaa	#$44
	ldab	#$01
	psha
	pshb
	ldaa	#$D1
	ldab	#$01	; base address of MeasArray
	psha
	pshb
	ldaa	#$03
	psha
	jsr	subRegisterSubtract	; 01D1 = 0167 - 0144
	ldaa	MeasArray0
	tsta
	bne	LBA37
	ldab	#$4B
	ldaa	#$01
	pshb
	psha
	ldaa	#$67
	ldab	#$01
	psha
	pshb
	ldaa	#$D1
	ldab	#$01	; base address of MeasArray
	psha
	pshb
	ldaa	#$03
	psha
	jsr	subRegisterSubtract	; 01D1 = 014B - 0167
	ldaa	MeasArray0
	tsta
	bne	LBA26
	rts

LBA26:
	ldaa	#$04
	oraa	X018C
	staa	X018C	; set bit2
	bsr	sub046
	rts
;
LBA37:
	ldaa	#$02
	oraa	X018C
	staa	X018C	; set bit1
	bsr	sub046
LBA41:
	rts
;===============================================================================
; Temperature measurement in C
; result returned in array 0167
subMathFcnTempC:
	clr	AccumRegister0
	ldaa	#$67
	ldab	#$01			; 0167 = base address of AccumRegister
	psha
	pshb
	ldaa	#$35
	ldab	#$F9	; F935 = 00 03 70 78 01 87 07 = 3.798E6
	psha
	pshb
	ldaa	#$B1
	ldab	#$01
	psha
	pshb
	ldaa	#$03
	psha
	jsr	subRegisterSubtract	; 01B1 = 0167 - F935

	ldaa	#$3C
	ldab	#$F9	; F93C = 00 09 26 55 48 87 02
	psha
	pshb
	ldaa	#$67
	ldab	#$01
	psha
	pshb
	ldaa	#$7D
	ldab	#$01
	psha
	pshb
	ldaa	#$03
	psha
	jsr	subRegisterSubtract	; 017D = F93C - 0167

	ldaa	X01B1
	tsta
	bne	LBA80	; branch if 01B1 array negative
	jmp	LBB13
;
LBA80:
	ldaa	X017D
	tsta
	bne	LBA89	; branch if 017D array negative
	jmp	LBB0F
;
LBA89:
	ldaa	#$27
	ldab	#$F9	; F927 = 00 03 13 40 00 00 04
	psha
	pshb
	ldaa	#$67
	ldab	#$01
	psha
	pshb
	ldaa	#$D1
	ldab	#$01	; base address of MeasArray
	psha
	pshb
	ldaa	#$03
	psha
	jsr	subRegisterSubtract	; 01D1 = F927 - 0167
	ldaa	MeasArray0
	inca
	ldx	#$0007
	stx	X0002
	clrb
	jsr	sub142
	staa	MeasArray0
	jsr	sub038
	ldaa	#$67
	ldab	#$01
	psha
	pshb
	ldaa	MeasArray0
	clrb
	adda	#$FD
	adcb	#$F8	; F8FD = FF 02 93 62 48 15 01
	psha		; F904 = FF 02 58 49 98 68 01
	pshb
	ldaa	#$67
	ldab	#$01
	psha
	pshb
	ldaa	#$03
	psha
	jsr	subRegisterSubtract	; 0167 = 0167 - F8FD
	ldaa	MeasArray0
	clrb
	adda	#$0B
	adcb	#$F9	; F90B = 00 02 30 79 75 58 04
	psha		; F912 = 00 02 06 34 99 98 04
	pshb
	ldaa	#$67
	ldab	#$01
	psha
	pshb
	psha
	pshb
	ldaa	#$03
	psha
	jsr	subRegisterDivide	; 0167 = F90B / 0167
	ldaa	#$67
	ldab	#$01
	psha
	pshb
	ldaa	MeasArray0
	clrb
	adda	#$19
	adcb	#$F9	; F919 =  00 03 22 80 76 84 03
	psha		; F920 = 00 03 03 33 01 82 03
	pshb
	ldaa	#$67
	ldab	#$01
	psha
	pshb
	ldaa	#$03
	psha
	jsr	subRegisterSubtract	; 0167 = 0167 - F919
	ldaa	#$0C
	staa	X019C
	rts

LBB0F:			; 017D array was positive
	jsr	sub036
	rts

LBB13:			; 01B1 array was positive
	jsr	sub035
	rts
;===============================================================================
; 20 LOG X/Y function
subMathFcn20LogXY:
	ldaa	RegisterY1	; byte 1 of Y register
	tsta
	bne	LBB22
	jmp	LBB56
;
LBB22:
	ldaa	#$67
	ldab	#$01			; 0167 = base address of AccumRegister
	psha
	pshb
	ldaa	#$36
	ldab	#$01
	psha
	pshb
	ldaa	#$67
	ldab	#$01
	psha
	pshb
	ldaa	#$03
	psha
	jsr	subRegisterDivide	; 0167 = 0167 / 0136
	jsr	sub038
	ldaa	#$67
	ldab	#$01
	psha
	pshb
	psha
	pshb
	psha
	pshb
	ldaa	#$03
	psha
	jsr	subRegisterAdd		; 0167 = 0167 + 0167 -> x 2
	inc	AccumRegister6		; inc exponent -> x 10
	ldaa	#$0C
	staa	X019C
	rts

LBB56:
	jsr	sub036
	rts
;===============================================================================
; Temperature measurement and conversion from C to F
; result placed in 0167 array
subMathFcnTempF:
	jsr	subMathFcnTempC
	ldaa	#$4A
	ldab	#$F9	;F94A : 00 01 80 00 00 00 01 = 1.8
	psha
	pshb
	ldaa	#$67
	ldab	#$01			; 0167 = base address of AccumRegister
	psha
	pshb
	psha
	pshb
	ldaa	#$03
	psha
	jsr	subRegisterMultiply	; 0167 = F94A * 0167
	ldaa	#$67
	ldab	#$01
	psha
	pshb
	ldaa	#$43
	ldab	#$F9	; F943 = 00 03 20 00 00 00 02 = 32
	psha
	pshb
	ldaa	#$67
	ldab	#$01
	psha
	pshb
	ldaa	#$03
	psha
	jsr	subRegisterAdd	; 0167 = 0167 + F943
	rts
;===============================================================================

sub051:
	ldaa	#$40
	anda	ioKBrdStrb
	tsta
	beq	LBB9F
	ldaa	flag010B
	rora
	bcc	LBB9F
	jsr	sub026
LBB9F:
	rts
;---------------------------------
; This initiates a measurement handshake to the Inguard.
subCheckIfIGReadyToMeasure:
	clr	ioIsoLogic	; sends 00 to Inguard
	ldx	#$FA00
	stx	x0117
	ldaa	x0118
	ldab	x0117
	psha
	pshb
	ldaa	#$01
	psha			; stack has 01 FA 00
	jsr	subWaitForIGStatus
	ldaa	flagInguardTimeout	; has value FF if timed out waiting for Inguard
	tsta
	beq	LBBC2
	jsr	subHandleIGTimeout	; deal with timeout
LBBC2:				; didn't time out
	ldaa	#$F1
	cmpa	ioIsoLogic
	beq	LBBCC		; if Inguard returned F1, goto return, appears to be code from IG that it's ready to measure.
	jsr	subHandleIGTimeout	; else deal with it
LBBCC:
	rts
;===============================================================================

subGetInguardReading:
	ldaa	#$10
	staa	ioHPIB_r0	; turn off interrupts from HPIB
	sei			; disable keyboard interrupts
	ldaa	#$F0
	staa	ioIsoLogic	; tell Inguard to take reading
	clra
	psha
	jsr	subWaitForIGbyte
	ldaa	ioIsoLogic
	staa	InguardByte0

	; first byte MSB = 1 indicates the measurement polarity is positive
	bpl	LBBEB		; branch if bit7 from inguard = 0
	ldaa	#$FF
	bra	LBBEC
LBBEB:
	clra
LBBEC:				; A = 00 if negative polarity, else FF
	rora			; LSB -> C
	bcc	LBBF6		; branch if C = 0, i.e., negative
	ldaa	#$99
	staa	x0119
	bra	LBBF9
;
LBBF6:
	clr	x0119
LBBF9:				; x0119 = 00 if negative polarity, else FF
	clra
	psha			; push 00 on stack
	jsr	subWaitForIGbyte
	ldaa	ioIsoLogic
	staa	InguardByte1
	clra
	psha
	jsr	subWaitForIGbyte
	ldaa	ioIsoLogic
	staa	InguardByte2
	clra
	psha
	jsr	subWaitForIGbyte
	ldaa	ioIsoLogic
	staa	InguardByte3
	cli			; enable keyboard interrupts
	ldaa	HPIBIntrMask
	staa	ioHPIB_r0	; set interrupts from HPIB to previous state
	ldaa	flagInguardTimeout ; = 00 if no timeout
	tsta
	beq	LBC2A
	jsr	subHandleIGTimeout	; inguard did time out
LBC2A:
	ldaa	flagNumPLCcode
	cmpa	#$03
	bls	LBC6B		; branch if flagNumPLCcode <= 03
	ldab	InguardByte3	; if PLC = 100, accumulate readings in AccumRegister
	addb	AccumRegister0
	tba			; B -> A
	daa			; convert addition result to BCD
	staa	AccumRegister0
	ldaa	InguardByte2
	adca	AccumRegister1
	daa
	staa	AccumRegister1
	ldaa	InguardByte1
	adca	AccumRegister2
	daa
	staa	AccumRegister2
	ldaa	InguardByte0
	adca	AccumRegister3
	daa
	staa	AccumRegister3
	ldaa	x0119		; x0119 = 00 if negative polarity, else FF
	adca	AccumRegister4
	daa
	staa	AccumRegister4	; extra digit for overflows when accumulating readings
	bra	LBC83
;
LBC6B:				; for PLC < 100, put reading directly into MeasArray
	ldaa	InguardByte3
	staa	MeasArray0
	ldaa	InguardByte2
	staa	MeasArray1
	ldaa	InguardByte1
	staa	MeasArray2
	ldaa	InguardByte0
	staa	MeasArray3
LBC83:
	rts
;===============================================================================
; Zeros contents of MeasArray.
subZeroMeasArray:
	clr	MeasArray0
	clr	MeasArray1
	clr	MeasArray2
	clr	MeasArray3
	clr	MeasArray4
	clr	MeasArray5
	clr	MeasArray6
	clr	MeasArray7
	rts
;===============================================================================
; separates pairs of BCD digits in MeasArray0-3 to individual digits MeasArray0-7
subUnpackMeasArray:
	ldaa	MeasArray3
	lsra
	lsra
	lsra
	lsra
	staa	MeasArray7	; high nibble
	ldaa	#$0F
	anda	MeasArray3
	staa	MeasArray6	; low nibble
	ldaa	MeasArray2
	lsra
	lsra
	lsra
	lsra
	staa	MeasArray5
	ldaa	#$0F
	anda	MeasArray2
	staa	MeasArray4
	ldaa	MeasArray1
	lsra
	lsra
	lsra
	lsra
	staa	MeasArray3
	ldaa	#$0F
	anda	MeasArray1
	staa	MeasArray2
	ldaa	MeasArray0
	lsra
	lsra
	lsra
	lsra
	staa	MeasArray1
	ldaa	#$0F
	anda	MeasArray0
	staa	MeasArray0
	ldaa	#$01
	staa	flagMeasArrayUnpacked	; = true
	ldaa	#$03
	anda	IGCmdRegister4
	staa	X011B		; bit0-1
	ldaa	flagNumPLCcode
	cmpa	#$01
	bcc	LBD00
	jsr	subShiftMeasArrayLeft
LBD00:
	ldaa	flagNumPLCcode
	cmpa	#$02
	bcc	LBD0F
	jsr	subShiftMeasArrayLeft
LBD0F:
	ldaa	flagNumPLCcode
	cmpa	#$03
	bcc	LBD19
	jsr	subShiftMeasArrayLeft
LBD19:
	rts
;===============================================================================
; Shifts MeasArray digits on right of decimal position right (MeasArray1 --> MeasArray0, etc)
; and puts 2E (ASCII ".") in proper display position (= 01D1 + DecimalDisplayPosition).
; DecimalDisplayPosition = 6 for "1" position on display, 5 for "10",
; 4 for "100" and 3 for "1K" positions.
; Inputs: DecimalDisplayPosition, X0198, X078C
; This is where the 7th digit is lost.
subInsertDisplayDecimal:
	ldaa	#$10
	anda	X0198
	tsta
	beq	LBD30	; branch if X0198 bit4 = 0
	ldaa	X078C
	cmpa	#$05
	bls	LBD30
	ldab	#$05
	stab	DecimalDisplayPosition	; if X078C >5, DecimalDisplayPosition = 5
LBD30:
	; ***** MODDED save the least significant digit before it is lost below *****
	ldaa	MeasArray0
	staa	Digit7
	; end mod

	clr	x011C	; loop index = 0,1,...
LBD33:
	ldaa	DecimalDisplayPosition
	deca
	cmpa	x011C
	bcs	LBD63	; branch out of loop if x011C > DecimalDisplayPosition
	ldaa	#$D1
	ldab	#$01	; base address of MeasArray
	adda	x011C
	adcb	#$00
	staa	x0049
	stab	x0048
	ldaa	x011C
	inca
	clrb
	adda	#$D1
	adcb	#$01
	staa	x004D
	stab	x004C
	ldx	x004C
	ldaa	$00,x	; MeasArray[i+1]
	ldx	x0048
	staa	$00,x	; MeasArray[i]	MeasArray0 will be overwritten, deleting 7th digit
	inc	x011C
	bra	LBD33
;
LBD63:
	ldaa	#$D1
	ldab	#$01
	adda	DecimalDisplayPosition
	adcb	#$00
	staa	x0049
	stab	x0048
	ldaa	#$2E	; ASCII "."
	ldx	x0048
	staa	$00,x
	rts
;===============================================================================
; Adds value BCDRoundupValue to packed MeasArray, uses BCD addition to propagate through array.
subBCDRoundup:
	ldaa	BCDRoundupValue
	adda	MeasArray0
	daa
	staa	MeasArray0
	ldaa	MeasArray1
	adca	#$00
	daa
	staa	MeasArray1
	ldaa	MeasArray2
	adca	#$00
	daa
	staa	MeasArray2
	ldaa	MeasArray3
	adca	#$00
	daa
	staa	MeasArray3
	rts
;===============================================================================
; Takes packed data in MeasArray0-3, determines polarity and uncompliments complimented
; data from Inguard.
subMeasSignNCompliment:
	ldaa	MeasArray1
	oraa	MeasArray0
	oraa	MeasArray3
	oraa	MeasArray2
	staa	MeasArrayORd
	ldaa	MeasArrayORd
	tsta
	bne	LBDBD		; branch if any MeasArray != 0
	ldab	#$2B		; ASCII "+"
	stab	MeasPolaritySign	; MeasPolaritySign = "+" if measurement bytes 1-4 are all 00
	bra	LBE1D		; no need to process all zeros
;

LBDBD:				; MeasArray has data
	ldaa	#$80
	anda	MeasArray3
	tsta
	beq	LBE04		; branch if bit7 = 0

	ldaa	#$10
	anda	IGCmdRegister1
	cmpa	#$10
	bne	LBDD5		; branch if IGCmdRegister1 bit4 != 0
	ldaa	#$2B
	staa	MeasPolaritySign	; "+" if IGCmdRegister1 bit4 = 0
	bra	LBDDA
LBDD5:
	ldaa	#$2D
	staa	MeasPolaritySign	; "-" if IGCmdRegister1 bit4 = 1

LBDDA:
	ldaa	#$99		; data arrives from Inguard in 10's compliment form
	suba	MeasArray3	; so convert first to 9's compliment
	staa	MeasArray3
	ldaa	#$99
	suba	MeasArray2
	staa	MeasArray2
	ldaa	#$99
	suba	MeasArray1
	staa	MeasArray1
	ldaa	#$99
	suba	MeasArray0
	staa	MeasArray0
	ldaa	#$01
	staa	BCDRoundupValue	; then add 1 to get uncomplimented values
	jsr	subBCDRoundup
	bra	LBE1D

LBE04:				; reach here if MeasArray3 bit7 = 0.  does it mean MeasArray is not in compliment form?
	ldaa	#$10
	anda	IGCmdRegister1
	tsta
	bne	LBE18
	ldaa	#$2B		; "+" if IGCmdRegister1 bit4 = 0
	staa	MeasPolaritySign
	bra	LBE1D
LBE18:
	ldaa	#$2D		; ASCII "-"
	staa	MeasPolaritySign
LBE1D:
	ldaa	flagNumPLCcode	; # power line cycles to integrate = 0,1,2,3,4 for .01,.1,1,10,100
	cmpa	#$02
	bls	LBE2C		; do a roundup for 10 & 100 PLC cases

	;***** MODDED don't round up if the 7th digit will be displayed
	ldaa	flag7Digits
	bne	LBE2C		; branch over roundup if in in 7 digit mode
	; end mod

	ldab	#$05
	stab	BCDRoundupValue
	jsr	subBCDRoundup
LBE2C:
	rts
;---------------------------------

subProcessMeasurement:
	jsr	subMeasSignNCompliment
	jsr	subUnpackMeasArray
	jsr	subInsertDisplayDecimal
	jsr	sub015
	jsr	subCopyMeasToAccumReg
	rts
;---------------------------------

sub060:
	ldaa	#$10
	anda	IGCmdRegister1
	tsta
	bne	LBEB0			; branch if bit4 = 1
	jsr	subCheckIfIGReadyToMeasure
	jsr	subZeroMeasArray
	ldaa	#$04
	cmpa	flagNumPLCcode		; 4 is the code for PLC = 100
	bne	LBE65
	ldab	#$03			; 3 is code for 10 PLC.  This change causes subGetInguardReading to put reading into MeasArra
	stab	flagNumPLCcode
	jsr	subGetInguardReading
	ldaa	#$04
	staa	flagNumPLCcode
	bra	LBE68
;
LBEB0:
	jmp	LBEF2
LBE65:
	jsr	subGetInguardReading
LBE68:
	ldaa	#$15
	cmpa	MeasArray3		; this is the first (most signifcant) byte from the IG, in 10's compliment form
	bne	LBE76
	ldab	#$01
	stab	X010C
	bra	LBE9F
;
LBE76:
	jsr	sub027
	bsr	subProcessMeasurement
	ldaa	flagOverrange_Maybe
	staa	x0119
	clr	flagOverrange_Maybe
	jsr	subTestForOverrange_Maybe
	ldaa	flagOverrange_Maybe
	staa	X010C
	ldaa	x0119
	staa	flagOverrange_Maybe
	ldaa	X01A7
	staa	MeasExponentSign
	ldaa	X01A6
	staa	MeasExponent
LBE9F:				; is this a post measurement test the IG is working correctly?
	ldaa	InguardCmd
	oraa	#$01
	anda	#$FD
	staa	InguardCmd	; clear bit1, set bit0
	ldaa	InguardCmd
	staa	ioIsoLogic	; send to Inguard
	ldx	#$00AA
	stx	x0117
	ldaa	#$10
	staa	ioHPIB_r0	; turn off interrupts from HPIB
	sei			; turn off keyboard interrupts
	ldaa	x0118
	ldab	x0117
	psha
	pshb
	ldaa	#$01
	psha			; stack has 01 00 AA
	jsr	subWaitForIGStatus
	cli			; turn on keyboard interrupts
	ldaa	HPIBIntrMask
	staa	ioHPIB_r0 	; resets interrupts from HPIB
	ldaa	flagInguardTimeout ; = 00 if no timeout
	tsta
	beq	LBEE3
	jsr	subHandleIGTimeout	; deal with timeout
LBEE3:
	ldaa	#$EF
	anda	ioIsoLogic	; clear bit4
	cmpa	InguardCmd	; Inguard returns cmd if it's OK
	beq	LBEF0
	jsr	subHandleIGTimeout
LBEF0:
	rts
;
LBEF2:
	clr	X010C
	ldaa	#$0F
	psha
	clrb
	pshb
	ldaa	#$01
	psha		; 01, 00, 0F on stack
	jsr	subProgrammedDelay
	rts
;---------------------------------

sub061:
	ldaa	#$F1
	anda	IGCmdRegister0
	staa	IGCmdRegister0	; clear bits3-1
	ldaa	#$06
	oraa	IGCmdRegister0
	staa	IGCmdRegister0	; set bits3-2
	ldaa	#$F1
	anda	CopyOfIGCmdByte
	staa	CopyOfIGCmdByte	; clear bits3-1
	ldaa	#$06
	oraa	CopyOfIGCmdByte
	staa	CopyOfIGCmdByte	; set bits3-2
	ldaa	CopyOfIGCmdByte
	lsra
	suba	#$10
	staa	X011B
	ldaa	#$AF
	ldab	#$F6
	;F6AF : 00 11 15 19
	adda	X011B
	adcb	#$00
	staa	x0049
	stab	x0048
	ldx	x0048
	ldaa	$00,x
	staa	InguardStatus
	rts
;---------------------------------
; sends command to Inguard and waits for status byte returned
; called from Sub063
sub062:
	ldaa	ioIsoLogic
	staa	InguardStatus
	ldaa	InguardCmd
	staa	ioIsoLogic
	ldx	#$00AA
	stx	x0117
	ldaa	x0118
	ldab	x0117
	psha
	pshb
	ldaa	#$01
	psha			; stack has 01 00 AA
	jsr	subWaitForIGStatus	; waits for status data from Inguard
	ldaa	flagInguardTimeout	; = 00 if no timeout
	tsta
	beq	LBF6C
	jsr	subHandleIGTimeout
LBF6C:
	ldaa	ioIsoLogic	; read byte from Inguard
	staa	InguardStatus
	ldaa	#$10
	anda	InguardStatus
	cmpa	#$10
	bne	LBF8A
	ldaa	#$EF		; if bit4 was set
	anda	InguardStatus
	staa	InguardStatus	; clear bit4
	ldaa	#$01
	staa	X011E		; = 01
	bra	LBF8D
;
LBF8A:
	clr	X011E		; = 00
LBF8D:
	rts
;===============================================================================

sub063:
	ldaa	#$40
	anda	ioHPIB_r1	; bit6 set if meter in HPIB Remote mode
	staa	x011C		; = 40 if unit in HPIB Remote mode, else 00
	ldaa	IGCmdRegister1	; from table lookups
	asla
	asla
	staa	InguardStatus
	ldaa	#$10
	anda	IGCmdRegister1
	tsta
	bne	LBFEC		; branch if bit4 = 1
	ldaa	IGCmdRegister0
	anda	#$10
	tsta
	beq	LBFD0		; branch if bit4 = 0
	ldaa	flagTestMode
	tsta
	bne	LBFD0		; branch if flagTestMode = 1
	ldab	x011C
	tstb
	bne	LBFC8		; branch if in Remote mode
	ldaa	#$10
	oraa	IGCmdRegister1
	staa	IGCmdRegister1	; set bit4
	bra	sub063		; back to top
;
LBFC8:
	ldaa	#$01
	staa	ErrorNumber
	jsr	subDisplayError
LBFD0:
	ldaa	#$07
	anda	IGCmdRegister1
	cmpa	#$02
	bls	LBFE0
	ldaa	#$8C
	staa	InguardCmd
	bra	LC00B
;
LBFE0:
	ldaa	#$0C
	anda	InguardStatus
	oraa	#$80
	staa	InguardCmd
	bra	LC00B
;
LBFEC:
	ldaa	#$07
	anda	IGCmdRegister1
	cmpa	#$02
	bls	LC001
	ldaa	#$8F
	staa	InguardCmd
	bra	LC00B
;
LC001:
	ldaa	#$0C
	anda	InguardStatus
	oraa	#$83
	staa	InguardCmd


LC00B:
	ldaa	#$E0
	anda	IGCmdRegister0
	ldab	#$08
	andb	IGCmdRegister1
	staa	x0048
	orab	x0048
	stab	x011F
	ldaa	#$A8
	clrb
	cmpa	x011F
	bne	LC025
	decb
LC025:
	ldaa	#$C8
	stab	x0048
	clrb
	cmpa	x011F
	bne	LC030
	decb
LC030:
	orab	x0048
	rorb
	bcc	LC050
	ldab	x011C
	tstb
	bne	LC048		; branch if in Remote mode
	ldaa	#$F7
	anda	IGCmdRegister1
	staa	IGCmdRegister1
	jmp	sub063
LC046:
	bra	LC050
;
LC048:
	ldaa	#$02
	staa	ErrorNumber
	jsr	subDisplayError
LC050:
	ldaa	#$20
	anda	InguardStatus
	oraa	InguardCmd
	staa	InguardCmd
	jsr	sub062		; sends cmd to Inguard, returns status
	ldaa	InguardStatus
	cmpa	InguardCmd
	beq	LC069		; OK status must be to return cmd
	jsr	subHandleIGTimeout
LC069:
	ldaa	X011E
	rora
	bcc	LC079
	ldaa	#$20		; if X011E was 1,
	oraa	IGCmdRegister1
	staa	IGCmdRegister1	; set bit5
	rts
;
LC079:
	ldaa	#$DF
	anda	IGCmdRegister1
	staa	IGCmdRegister1	; else clear bit5
	rts
;---------------------------------
; called from sub065
;
;F6AF : 00 11 15 19
;F6B3 : 1D 00 00 00

sub064:
	ldaa	#$02
	adda	IGCmdRegister0
	staa	IGCmdRegister0	; increase by 2
	ldaa	#$02
	adda	CopyOfIGCmdByte
	staa	CopyOfIGCmdByte
	inc	X011B
	ldaa	#$AF
	ldab	#$F6
	adda	X011B
	adcb	#$00
	staa	x0049
	stab	x0048
	ldx	x0048	; F6AF + X011B
	ldaa	$00,x
	staa	InguardStatus
	rts
;---------------------------------
; appears to send 4 bytes to Inguard to set measurement mode
sub065:
	jsr	sub063
	ldaa	CopyOfIGCmdByte
	lsra
	suba	#$10
	staa	X011B
	clrb
	adda	#$AF
	adcb	#$F6
	staa	x004D
	stab	x004C
	ldx	x004C	; F6AF + CopyOfIGCmdByte/2 - 10 (=F6C0 in one run)
	ldaa	$00,x	; (=10 in this run)
	staa	InguardStatus
	ldaa	#$0E
	anda	IGCmdRegister0	; bits3-1
	cmpa	#$06
	bls	LC0F7
	ldaa	#$F0
	anda	IGCmdRegister0	; bits7-4
	staa	x011C
	ldaa	#$B0
	clrb
	cmpa	x011C
	bne	LC0E4
	decb
LC0E4:
	ldaa	#$D0
	stab	x0048
	clrb
	cmpa	x011C
	bne	LC0EF
	decb
LC0EF:
	orab	x0048
	rorb
	bcc	LC0F7
	clr	InguardStatus
LC0F7:
	ldaa	InguardStatus
	tsta
	bne	LC163
	ldab	CopyOfIGCmdByte
	andb	#$01
	tstb
	beq	LC10A
	jsr	sub061
	bra	LC171
LC163:
	jmp	LC1BB
;
LC10A:
	ldaa	#$40
	anda	ioHPIB_r1	; bit6 set if meter in HPIB Remote mode
	tsta
	bne	LC181
	ldaa	#$EF
	anda	CopyOfIGCmdByte
	staa	x011C
	ldaa	#$40
	clrb
	cmpa	x011C
	bne	LC128
	decb
LC128:
	ldaa	#$20
	stab	x0048
	clrb
	cmpa	x011C
	bne	LC133
	decb
LC133:
	orab	x0048
	stab	X011E
	ldaa	#$0F
	anda	CopyOfIGCmdByte
	clrb
	tsta
	bne	LC142
	decb
LC142:
	andb	X011E
	rorb
	bcc	LC186
	ldaa	#$02
	oraa	IGCmdRegister0
	staa	IGCmdRegister0	; set bit1
	ldaa	#$02
	oraa	CopyOfIGCmdByte
	staa	CopyOfIGCmdByte
	ldaa	CopyOfIGCmdByte
	lsra
	suba	#$10
	staa	X011B
	ldaa	#$AF
	ldab	#$F6
	adda	X011B
	adcb	#$00
	bra	LC174
LC171:
	jmp	LC1AD
;
LC174:
	staa	x0049
	stab	x0048
	ldx	x0048
	ldaa	$00,x
	staa	InguardStatus
	bra	LC184
LC181:
	jmp	LC1AD
LC184:
	bra	LC1AD
;
LC186:
	jsr	sub061
	ldaa	#$F0
	anda	IGCmdRegister0	; bits7-4
	staa	X011E
	ldaa	#$B0
	clrb
	cmpa	X011E
	bne	LC19A
	decb
LC19A:
	ldaa	#$D0
	stab	x0048
	clrb
	cmpa	X011E
	bne	LC1A5
	decb
LC1A5:
	orab	x0048
	tstb
	bne	LC1AD
	jsr	sub064
LC1AD:
	ldaa	InguardStatus
	tsta
	bne	LC1BB
	ldab	#$03
	stab	ErrorNumber
	jsr	subDisplayError
LC1BB:
	ldaa	InguardStatus
	lsra
	lsra
	lsra
	lsra
	oraa	#$60	; set bit6-5
	staa	ioIsoLogic	; send command to Inguard
	ldaa	#$02
	psha
	clrb
	pshb
	ldaa	#$01
	psha		; 01, 00, 02 on stack
	jsr	subProgrammedDelay
	ldaa	#$0F
	anda	InguardStatus
	oraa	#$70	; set bit6-4
	staa	ioIsoLogic	; send command to Inguard
	ldaa	#$02
	psha
	clrb
	pshb
	ldaa	#$01
	psha		; 01, 00, 02 on stack
	jsr	subProgrammedDelay
	ldaa	#$0F
	ldab	#$F7
	adda	X011B
	adcb	#$00
	staa	x0049
	stab	x0048
	ldx	x0048
	ldaa	$00,x
	staa	InguardStatus
	ldaa	InguardStatus
	lsra
	lsra
	lsra
	lsra
	oraa	#$40	; set bit6
	staa	ioIsoLogic	; send command to Inguard
	ldaa	#$02
	psha
	clrb
	pshb
	ldaa	#$01
	psha		; 01, 00, 02 on stack
	jsr	subProgrammedDelay
	ldaa	#$0F
	anda	InguardStatus
	oraa	#$50
	staa	ioIsoLogic
	ldaa	#$08
	anda	IGCmdRegister1
	tsta
	beq	LC232
	ldaa	#$94
	ldab	#$11
	psha
	pshb
	ldaa	#$01
	psha		; 01, 11, 94 on stack
	jsr	subProgrammedDelay
	bra	LC23D
;
LC232:
	ldaa	#$1A
	psha
	clrb
	pshb
	ldaa	#$01
	psha		; 01, 00, 1A on stack
	jsr	subProgrammedDelay
LC23D:
	jsr	sub060
	rts
;---------------------------------

sub066:
	ldaa	#$EF
	anda	IGCmdRegister0
	staa	CopyOfIGCmdByte
	jsr	sub065
	jsr	sub028
	jsr	sub010
	rts
;===============================================================================
; Determines HPIB idle (Talker Active, Ready for Data, Output Empty) status
; Sets flagHPIBOutputStatus
subHPIB_Idle:
	ldaa	#$10
	staa	ioHPIB_r0	; turn off interrupts from HPIB
	ldaa	#$10
	anda	ioHPIB_r3	; A = 10 if interface Ready For Data
	ldab	#$40
	andb	ioHPIB_r0	; B = 40 if HPIB output register empty
	staa	x0048
	orab	x0048
	ldaa	#$08
	anda	ioHPIB_r2	; A = 08 if Talker Active state
	stab	x004C
	oraa	x004C
	staa	flagHPIBOutputStatus	; = Talker Active (08) | Ready for Data (10) | Output Empty (40)
	ldaa	HPIBIntrMask
	staa	ioHPIB_r0	; restore to previous interrupt state
	rts
;===============================================================================
; Loops until HPIB port is idle, then updates front panel. Called after a byte
; is written to ioHPIB_r7 output register.
;
subWaitForHPIB_Idle:
	ldaa	#$10
	staa	ioHPIB_r0	; turn off interrupts from HPIB
LC284:
	ldaa	#$10
	anda	ioHPIB_r3	; A = 10 if interface Ready For Data
	ldab	#$40
	andb	ioHPIB_r0	; B = 40 if HPIB output register empty
	staa	x0048
	orab	x0048
	ldaa	#$08
	anda	ioHPIB_r2	; A = 08 if Talker Active state
	stab	x004C
	oraa	x004C		; A = Talker Active (08) | Ready for Data (10) | Output Empty (40)
	cmpa	#$58
	beq	LC2B8		; branch if all three true, then return
	ldaa	flagDispNeedUpdate	; = 1 if display needs to be updated
	rora
	bcc	LC2AB		; branch if flag = 0
	jsr	subSetAnnuncByte4
	jsr	subUpdateDisplayIfReady
LC2AB:
	ldaa	HPIBIntrMask
	staa	ioHPIB_r0	; restore to previous interrupt state
	ldaa	#$10
	staa	ioHPIB_r0	; turn off interrupts from HPIB (?)
	bra	LC284
LC2B8:
	rts
;===============================================================================
; Outputs data in 01B8 to 01C4 to HPIB
;
subHPIBOutputReadingUnpacked:
	clr	x01B0	; loop index
LC2BE:
	ldaa	x01B0	; 0 to B, 12 iterations
	cmpa	#$0B
	bhi	LC2E0
	ldaa	#$B8
	ldab	#$01
	adda	x01B0
	adcb	#$00
	staa	x0049
	stab	x0048
	ldx	x0048	; 01B8 to 01C4
	ldaa	$00,x
	staa	ioHPIB_r7	; send out on HPIB
	bsr	subWaitForHPIB_Idle

	;***** MODDED to output 7th digit *****
	ldaa	x01B0
	cmpa	#$08		; has last digit of the mantissa just been output?
	bne	LC2BF		; branch if no
	jsr	sub7thDigitShown	; FIX: was ldaa flag7Digits
	beq	LC2BF		; branch if no
	ldaa	Digit7
	adda	#$30		; convert to ASCII
	staa	ioHPIB_r7	; slip 7th digit into output
	bsr	subWaitForHPIB_Idle
	; end mod
LC2BF:
	inc	x01B0
	bra	LC2BE
LC2E0:
	rts
;===============================================================================
;
subHPIBOutputReadingPacked:

	ldaa	FormattedReading2
	staa	ioHPIB_r7
	bsr	subWaitForHPIB_Idle
	ldaa	FormattedReading3
	staa	ioHPIB_r7
	bsr	subWaitForHPIB_Idle
	ldaa	FormattedReading4
	staa	ioHPIB_r7
	bsr	subWaitForHPIB_Idle
	rts
;===============================================================================
; Outputs a measurement on HPIB whether packed or unpacked, single or multiple
; readings.
subHPIBOutputMeasurement:

	ldaa	HPIBIntrMask
	staa	ioHPIB_r0
	ldaa	#$80
	anda	IGCmdRegister4
	tsta
	beq	LC34B		; branch if bit7 = 0
	;--- code block, output 0 or 1 and return
	ldaa	#$20
	anda	IGCmdRegister1
	tsta
	beq	LC31B
	ldaa	#$30		; ASCII "0"
	staa	x01CA
	bra	LC320
;
LC31B:
	ldaa	#$31		; ASCII "1"
	staa	x01CA
LC320:
	ldaa	#$7F
	anda	IGCmdRegister4
	staa	IGCmdRegister4	; clear bit3
	ldaa	x01CA
	staa	ioHPIB_r7
	jsr	subWaitForHPIB_Idle
	ldaa	#$0D		; ASCII [cr]
	staa	ioHPIB_r7
	jsr	subWaitForHPIB_Idle
	ldaa	flagOutputEOI
	rora
	bcc	LC344
	ldaa	#$20
	staa	ioHPIB_r3	; puts EOI signal on HPIB
LC344:
	ldaa	#$0A		; ASCII [lf]
	staa	ioHPIB_r7
	bra	LC3B2
	;--- end code block
;
LC34B:	;--- code block output packed reading
	ldaa	flagMeasFormatted
	rora
	bcc	LC3B2		; rts if flagMeasFormatted = 0
	jsr	subSetAnnuncByte4
	ldaa	flagHPIBPackedOutput
	rora
	bcc	LC388		; branch if unpacked output
	ldaa	#$10
	anda	flagX0121
	tsta
	beq	LC372		; branch if flagX0121 bit4 = 0
	jsr	subHPIBOutputReadingPacked	; outputs packed data without EOI
	ldaa	FormattedReading5
	staa	ioHPIB_r7
	bra	LC3B2
;
LC372:
	jsr	subHPIBOutputReadingPacked	; outputs packed data perhaps with EOI
	ldaa	flagOutputEOI
	rora
	bcc	LC380
	ldaa	#$20
	staa	ioHPIB_r3	; puts EOI signal on HPIB
LC380:
	ldaa	FormattedReading5
	staa	ioHPIB_r7
	bra	LC3B2
	;--- end code block

LC3B2:
	jmp	LC3F7
;
LC388:	;--- code block output unpacked data
	ldaa	flagHPIBPackedOutput		; already tested above
	tsta
	bne	LC3F7		; should never occur
	ldab	#$10
	andb	flagX0121
	tstb
	beq	LC3BF		; branch if flagX0121 bit4 = 0
	ldab	#$80
	andb	flagHPIBOutput	; bit7 = 1 means output multiple readings, comma separated
	tstb
	beq	LC3A8		; branch if bit7 = 0
	ldab	#$2C		; ASCII ","
	stab	ioHPIB_r7
	jsr	subWaitForHPIB_Idle
	jsr	subHPIBOutputReadingUnpacked
	bra	LC3F7
;
LC3A8:
	ldaa	#$80
	oraa	flagHPIBOutput
	staa	flagHPIBOutput	; set bit7
	jsr	subHPIBOutputReadingUnpacked
	bra	LC3F7
;
LC3BF:
	ldaa	#$80
	anda	flagHPIBOutput
	tsta
	beq	LC3CF		; branch if bit7 = 0
	ldaa	#$2C		; ASCII ","
	staa	ioHPIB_r7
	jsr	subWaitForHPIB_Idle
LC3CF:
	jsr	subHPIBOutputReadingUnpacked
	ldaa	#$0D		; ASCII [cr]
	staa	ioHPIB_r7
	jsr	subWaitForHPIB_Idle
	ldaa	flagOutputEOI
	rora
	bcc	LC3E5
	ldaa	#$20
	staa	ioHPIB_r3	; puts EOI signal on HPIB
LC3E5:
	ldaa	#$0A		; ASCII [lf]
	staa	ioHPIB_r7
	ldaa	#$7F
	anda	flagHPIBOutput	; clear bit7
	staa	flagHPIBOutput
LC3F7:
	clr	flagMeasFormatted
	ldaa	#$FB
	staa	HPIBSerialPollMask
	jsr	subUpdateHPIBSerialPoll
	rts
;===============================================================================
; If the HPIB is idle, outputs a measurement, otherwise just returns.
subOutputMeasWhenHPIBReady:
	clr	flagHPIBOutputStatus
	jsr	subHPIB_Idle	; Determines HPIB idle (not busy) status
	ldaa	#$58		; 58 means idle
	cmpa	flagHPIBOutputStatus
	bne	LC415		; branch if HPIB still busy
	jsr	subHPIBOutputMeasurement
LC415:
	rts
;===============================================================================

sub073:
	jsr	subSetAnnuncBytes123
	jsr	subSetAnnuncByte4
	jsr	subUpdateDisplayIfReady
	bsr	subOutputMeasWhenHPIBReady
	rts
;---------------------------------

subClearDisplay:
	clr	DisplayArray7
	ldaa	#$0A		; 0A will display dashes
	staa	DisplayArray6
	staa	DisplayArray5
	staa	DisplayArray4
	staa	DisplayArray3
	staa	DisplayArray2
	staa	DisplayArray1
	staa	DisplayArray0
	clr	DisplayPolaritySign
	clr	flagDisplayHasExponent
	clr	DisplayExponentSign
	clr	flagDisplayArrayHasNoDecimal
	jsr	subAnnuncNDisplayUpdate
	rts
;---------------------------------

sub075:
	ldaa	#$02
	anda	flagX0121
	cmpa	#$02
	bne	LC4DB		; return if bit1 = 0
	ldaa	X012E
	staa	InguardByte3
	ldaa	X012D
	staa	InguardByte2
	ldaa	X012C
	staa	InguardByte1
	ldaa	flag010B
	rora
	bcc	LC482
	jsr	subSetAnnuncBytes123
	jsr	subSetAnnuncByte4
	jsr	sub026
	jsr	subAnnuncNDisplayUpdate
	clr	flag010B
LC482:
	ldaa	InguardByte2
	oraa	InguardByte1
	oraa	InguardByte3
	tsta
	beq	LC4DB		; return if bytes2-4 all zero
	ldaa	#$0D
	psha
	clrb
	pshb
	ldaa	#$01
	psha			; 01, 00, 0D on stack
	jsr	subProgrammedDelay
	ldaa	#$99		; Inguard sends bytes as compliments
	adda	InguardByte3
	daa			; BCD adjust
	staa	InguardByte3
	ldaa	#$99
	adca	InguardByte2
	daa
	staa	InguardByte2
	ldaa	#$99
	adca	InguardByte1
	daa
	staa	InguardByte1
	clr	X011B		; duplicates for timing?
	clr	X011B
	clr	X011B
	clr	X011B
	clr	X011B
	clr	X011B
	clr	X011B
	clr	X011B
	clr	X011B
	bra	LC482		; looping back here.  Does an interrupt put data into InguardByte1-4?
LC4DB:
	rts
;---------------------------------

sub076:
	ldaa	#$40
	anda	ioKBrdStrb
	tsta
	beq	LC4EC
	jsr	sub051
	jsr	sub073
LC4EC:
	rts
;---------------------------------

sub077:
	ldaa	#$01
	staa	x011C
	ldaa	#$08
	anda	flagX0121
	cmpa	#$08
	bne	LC541
	clr	x011C
	ldaa	X012A
	clrb
	cmpa	X018F
	beq	LC50A
	decb
LC50A:
	ldaa	X012B
	stab	x0048
	clrb
	cmpa	X018E
	beq	LC516
	decb
LC516:
	orab	x0048
	rorb
	bcc	LC541
	ldab	IGCmdRegister1
	andb	ioHPIB_r4
	andb	#$40		; bit6 set means an external trigger input has occurred
	tstb
	beq	LC53C
	ldab	#$08		; deal with external trigger
	stab	HPIBSerialPollStatus
	jsr	subHPIBRequestService
	ldaa	X012A
	staa	X018F
	ldaa	X012B
	staa	X018E
	bra	LC541
;
LC53C:
	ldaa	#$01
	staa	flagHPIBByteInIntr
LC541:
	ldaa	#$C0
	anda	IGCmdRegister1
	staa	x0119
	cmpa	#$40
	bne	LC582
	ldab	ioHPIB_r4
	andb	#$40		; bit6 set means an external trigger input has occurred
	tstb
	beq	LC562
	ldab	#$08		; deal with external trigger
	stab	HPIBSerialPollStatus
	jsr	subHPIBRequestService
LC562:
	ldaa	#$40
	anda	ioHPIB_r4
	oraa	flagHPIBByteInIntr
	tsta
	bne	LC572
	jsr	sub076
	bra	LC562
;
LC572:
	clr	ioIOreset
	ldaa	#$0C
	psha
	clrb
	pshb
	ldaa	#$01
	psha		; 01, 00, 0C on stack
	jsr	subProgrammedDelay
	bra	LC5A6
;
LC582:
	ldaa	#$80
	clrb
	cmpa	x0119
	bne	LC58B
	decb
LC58B:
	ldaa	#$C0
	stab	x0048
	clrb
	cmpa	x0119
	bne	LC596
	decb
LC596:
	orab	x0048
	tstb
	beq	LC5A6
LC59B:
	ldaa	flagHPIBByteInIntr
	tsta
	bne	LC5A6
	jsr	sub076
	bra	LC59B
;
LC5A6:
	clr	flagHPIBByteInIntr
	ldaa	x011C
	tsta
	bne	LC5FF
	ldab	#$10
	orab	flagX0121
	stab	flagX0121
	ldaa	X018F
	clrb
	tsta
	bne	LC5BF
	decb
LC5BF:
	ldaa	X018E
	stab	x0048
	clrb
	cmpa	#$01
	bne	LC5CA
	decb
LC5CA:
	andb	x0048
	rorb
	bcc	LC5E5
	ldab	#$EF
	andb	flagX0121
	stab	flagX0121
	ldaa	X012A
	staa	X018F
	ldaa	X012B
	staa	X018E
	bra	LC5FF
;
LC5E5:
	ldaa	#$10
	oraa	flagX0121
	staa	flagX0121
	ldaa	#$99
	adda	X018E
	daa
	staa	X018E
	ldaa	#$99
	adca	X018F
	daa
	staa	X018F
LC5FF:
	rts
;---------------------------------
; inputs MeasArray0-3 in raw packed and complimented form
sub078:
	jsr	subMeasSignNCompliment
	ldaa	MeasArrayORd	; MeasArray0-3 (packed bytes) or'd together
	tsta
	beq	LC626		; branch if MeasArray are all 00
	ldab	#$10
	andb	X0198
	tstb
	beq	LC626		; branch if X0198 bit4 = 0
	ldab	#$2B		; ASCII "+"
	cmpb	MeasPolaritySign
	bne	LC621

	ldaa	#$2D		; ASCII "-"
	staa	MeasPolaritySign	; if if X0198 bit4 != 0 and MeasPolaritySign = "+", make it "-"
	bra	LC626

LC621:				; X0198 bit4 = 0 and MeasPolaritySign != "+"
	ldaa	#$2B		; make MeasPolaritySign "+"
	staa	MeasPolaritySign

LC626:
	ldaa	MeasPolaritySign
	lsra			; = 0x15 or 0x16 (or 00 if MeasArray all 00?)
	staa	InguardStatus
	ldaa	#$02
	anda	InguardStatus
	staa	InguardStatus	; = 00 (if "+") or 02 (if "-")
	ldaa	X0124
	oraa	InguardStatus
	staa	InguardStatus
	ldaa	flagNumPLCcode
	tsta
	bne	LC65D
	ldab	MeasArray2	; PLC = .01, 4 digits maximum can be diplayed
	andb	#$01		; overrange digit must be in MeasArray2 lower nibble
	orab	InguardStatus
	stab	FormattedReading2
	ldaa	MeasArray1
	staa	FormattedReading3
	ldaa	MeasArray0
	staa	FormattedReading4
	jmp	LC742
;
;
LC65D:
	ldaa	flagNumPLCcode
	cmpa	#$01
	bne	LC6B8
	ldab	MeasArray2	; PLC = .1, 5 digits maximum can be diplayed
	lsrb
	lsrb
	lsrb
	lsrb
	andb	#$01		; overrange digit must be in MeasArray2 higher nibble
	orab	InguardStatus
	stab	FormattedReading2
	ldaa	#$0F
	anda	MeasArray2
	asla
	asla
	asla
	asla
	ldab	#$F0
	andb	MeasArray1
	lsrb
	lsrb
	lsrb
	lsrb
	staa	x004A
	orab	x004A
	stab	FormattedReading3
	ldaa	#$0F
	anda	MeasArray1
	asla
	asla
	asla
	asla
	ldab	#$F0
	andb	MeasArray0
	lsrb
	lsrb
	lsrb
	lsrb
	staa	x004A
	orab	x004A
	stab	FormattedReading4
	ldaa	#$0F
	anda	MeasArray0
	asla
	asla
	asla
	asla
	staa	FormattedReading5
	jmp	LC742
;
LC6B8:				; PLC = 1,10 or 100 so 6 digits maximum can be diplayed
	ldaa	#$02
	cmpa	flagNumPLCcode
	bne	LC6E3
	ldab	MeasArray3	; here for PLC = 1
	andb	#$01
	orab	InguardStatus
	stab	FormattedReading2
	ldaa	MeasArray2
	staa	FormattedReading3
	ldaa	MeasArray1
	staa	FormattedReading4
	ldaa	MeasArray0
	staa	FormattedReading5
	bra	LC742
;
LC6E3:				; here for PLC = 10 or 100 (subRunMeasurement takes care of 100 PLC)
	ldaa	MeasArray3
	lsra
	lsra
	lsra
	lsra
	anda	#$01
	oraa	InguardStatus
	staa	FormattedReading2
	ldaa	#$0F
	anda	MeasArray3
	asla
	asla
	asla
	asla
	ldab	#$F0
	andb	MeasArray2
	lsrb
	lsrb
	lsrb
	lsrb
	staa	x004A
	orab	x004A
	stab	FormattedReading3
	ldaa	#$0F
	anda	MeasArray2
	asla
	asla
	asla
	asla
	ldab	#$F0
	andb	MeasArray1
	lsrb
	lsrb
	lsrb
	lsrb
	staa	x004A
	orab	x004A
	stab	FormattedReading4
	ldaa	#$0F
	anda	MeasArray1
	asla
	asla
	asla
	asla
	ldab	#$F0
	andb	MeasArray0
	lsrb
	lsrb
	lsrb
	lsrb
	staa	x004A
	orab	x004A
	stab	FormattedReading5

LC742:				; here all the reading bytes have been transferred
	ldaa	FormattedReading2
	anda	#$01
	rora
	bcc	LC758		; branch if overrange digit is 0
	ldaa	#$F0
	anda	FormattedReading3
	cmpa	#$10
	bls	LC758
	ldaa	#$01
	staa	flagOverrange_Maybe
LC758:
	ldaa	X010C
	oraa	flagOverrange_Maybe
	staa	flagOverrange_Maybe
	ldaa	flagOverrange_Maybe
	tsta
	bne	LC76A
	jsr	subStoreReading
LC76A:
	ldaa	#$30
	anda	IGCmdRegister4
	cmpa	#$20
	beq	LC7D9	; branch if bit5 set, bit4 clear
	jsr	subUnpackMeasArray
	ldaa	MeasArray7
	clrb
	cmpa	#$01
	bne	LC77F
	decb
LC77F:
	ldaa	MeasArray6
	stab	x0048
	clrb
	cmpa	#$01
	bls	LC78A
	decb
LC78A:
	andb	x0048
	rorb
	bcc	LC796
	ldab	#$01
	stab	flagOverrange_Maybe
LC7D9:
	rts
;
LC796:
	jsr	subInsertDisplayDecimal
	ldaa	flagHPIBPackedOutput
	tsta
	bne	LC7AE
	ldab	#$10
	stab	ioHPIB_r0	; turn off interrupts from HPIB
	sei
	jsr	subFormatReadingForHPIB
	cli
	ldaa	#$A5
	staa	ioHPIB_r0	; turn on interrupts from HPIB
LC7AE:
	ldaa	flagDispNeedUpdate
	rora
	bcc	LC7D9
	ldaa	#$10
	anda	X0198
	clrb
	tsta
	beq	LC7BE
	decb
LC7BE:
	ldaa	#$2B	; ASCII "+"
	stab	x004A
	clrb
	cmpa	MeasPolaritySign
	bne	LC7C9
	decb
LC7C9:
	andb	x004A
	ldaa	#$80
	anda	X0198
	stab	x004E
	clrb
	tsta
	beq	LC7D7
	decb
LC7D7:
	orab	x004E
	rorb
	bcc	LC7E6
	ldaa	#$1F
	staa	MeasPolaritySign	; 1F code for blank sign?
LC7E6:
	ldaa	flagNumPLCcode
	tsta
	bne	LC7F4		; branch if PLC != .01
	ldab	#$0F
	stab	MeasArray0	; 0F means blank these two digits
	stab	MeasArray1
LC7F4:
	ldaa	flagNumPLCcode
	cmpa	#$01
	bne	LC805		; branch if PLC != .1
	ldab	#$0F
	stab	MeasArray0	; blank just this digit
LC805:
	ldaa	#$03
	staa	x011C		; loop index, 3 to ?
LC80A:	;--- loop begin
	ldaa	#$05
	suba	X011B		; X011B contains code for # digits to display?
	cmpa	x011C
	bcs	LC832
	ldaa	x011C
	suba	#$03		; A = 0 to ?
	clrb
	adda	#$D1
	adcb	#$01		; base address of MeasArray
	staa	x004B
	stab	x004A
	ldaa	#$0F
	ldx	x004A
	staa	$00,x		; 0F blanks digit least significant digit MeasArray0 to ?
	inc	x011C
	bra	LC80A
	;--- loop end
;
LC832:
	ldaa	MeasArray7	; most signifcant digit
	tsta
	bne	LC83D
	ldab	#$0F		; if 0, blank digit
	stab	MeasArray7
LC83D:
	rts
;===============================================================================
; This runs measurements in all modes.  If 100 Power Line Cycle integration is in effect,
; this runs a loop of 10, 10 PLC measurements.  Loop index X01A0 starts at 0A and decrements.
; For 100 PLC, measurements accumulated into AccumRegister, then transfered to MeasArray.
; Less than 100 PLC measurement are done in MeasArray.

subRunMeasurement:
	jsr	subCheckIfIGReadyToMeasure
	ldaa	X0198
	anda	#$01
	rora
	bcc	LC857
	ldaa	flagNumPLCcode
	cmpa	#$04
	bcc	LC857
	ldab	#$10
	stab	ioVmComplete	; if PLC code > 4, signal VM complete?
LC857:
	jsr	subZeroMeasArray
	clr	FormattedReading5
	ldaa	flagNumPLCcode
	cmpa	#$03
	bls	LC8CE		; branch if 10 PLC or less
	jsr	subClearAccumRegister
	ldaa	#$0A		; decimal 10
	staa	X01A0
	ldaa	#$FB
	anda	flagX0121
	staa	flagX0121	; clear bit2
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
