jlpoltrack/HP3456A-7.5/(commit log)

2026-10-19 HP 3456A 7.5-digit firmware with fixes
    Fixed source for the community 7.5-digit U7 firmware: seven restructuring
    bugs fixed (including the autorange freeze), 7th digit gated by PLC and
    number entry. Validated on hardware 2026-10-19 (tests 1-14 pass).
    Includes assembler/compare tools, flash adapter and validation docs.
    [u7fixed.asm]
2026-10-24 Import the U7 flash adapter KiCad project (27C256-Flash)
    Unfinished 28-to-32-pin adapter: DIP-28 plug for U7, SST39SF040 socket,
    A15-A18 bank jumpers. Moved here from its own folder to finish it.
    [27C256-Flash.kicad_pcb, 27C256-Flash.kicad_sch]
2026-10-24 U7 flash adapter V1.0: rebuilt schematic and routed 2-layer board
    SST39SF040 socket offset 5.1 mm / two rows from the DIP-28 plug, so all
    26 signals are straight 1:1 links. Adds JP1 (U7 pin 28 to +5V, open
    until the pin is measured), a C1 wire pad, 100n decoupling, and 10k
    pull-downs on A15-A18 (no jumpers = bank 0); the J3 GND row is dropped.
    DRC/ERC/lint clean; gerbers, PDF, renders and docs updated.
    [27C256-Flash.kicad_pcb, 27C256-Flash.kicad_sch, U7-Flash-Adapter.kicad_pcb, U7-Flash-Adapter.kicad_sch, bom.csv, designators.csv, positions.csv]
